apimentel1/CatchTheLight/Documentation/Phase2.md

### Front of PCB
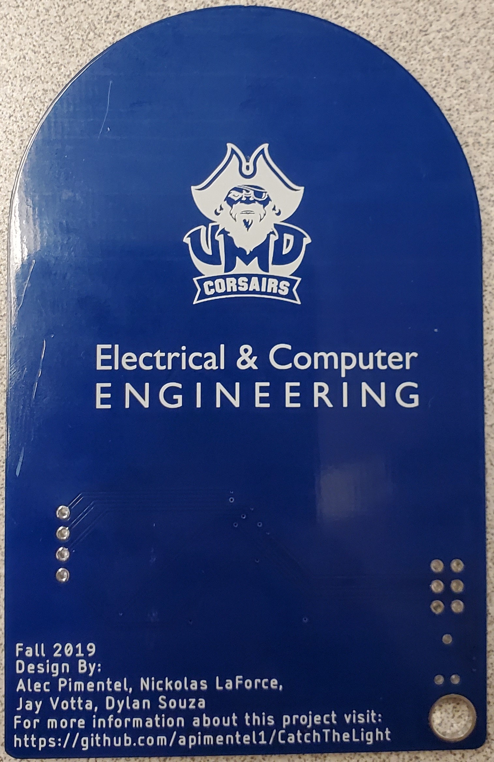
[picture p14: Documentation/Images/Phase2_PCB_Back.jpg]


### Back of PCB
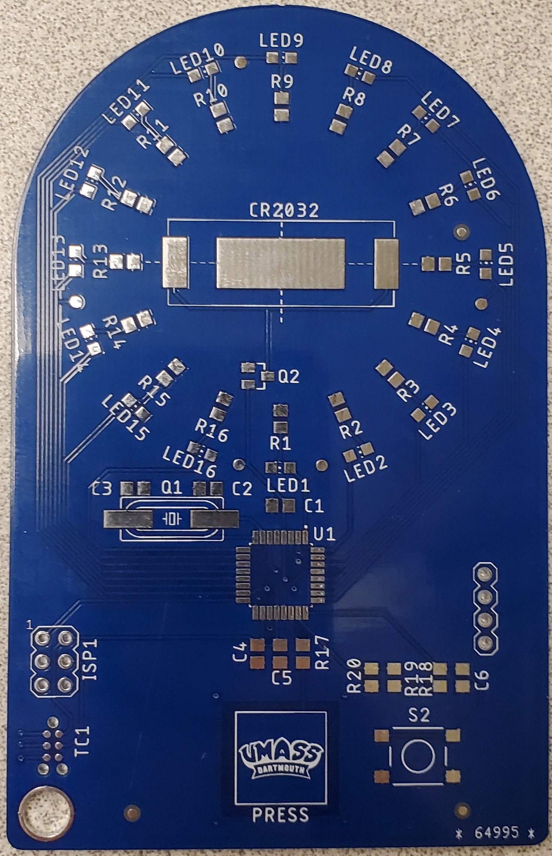
[picture p15: Documentation/Images/Phase2_PCB_Front.jpg]
