apimentel1/CatchTheLight/Initial design_reverse engineered/catch the light initial/Gerbers/CAMOutputs/Gerb screen shot Phase 1.docx

Team Life Support

Phase 1 design

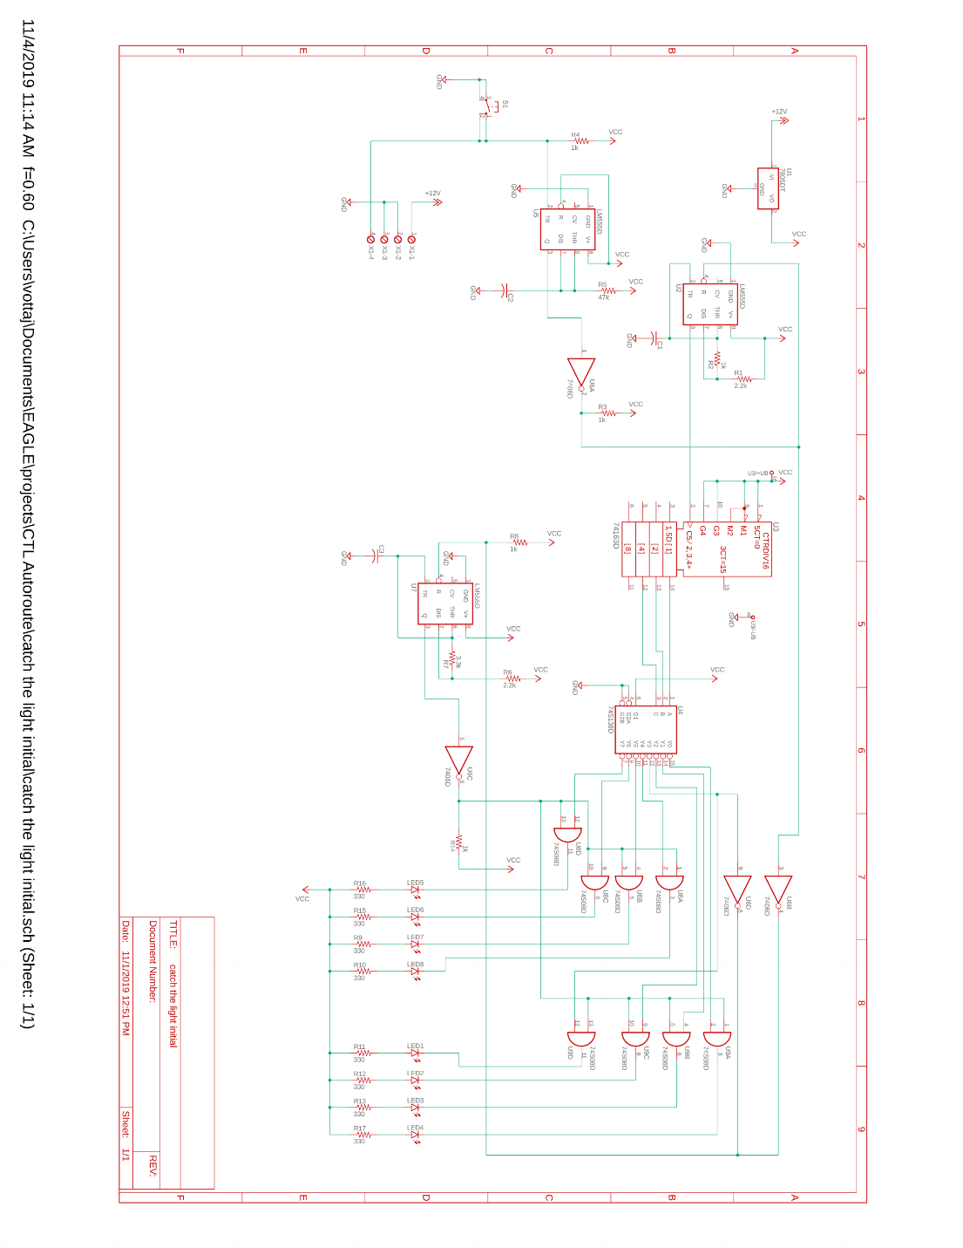
[picture p27: figure]
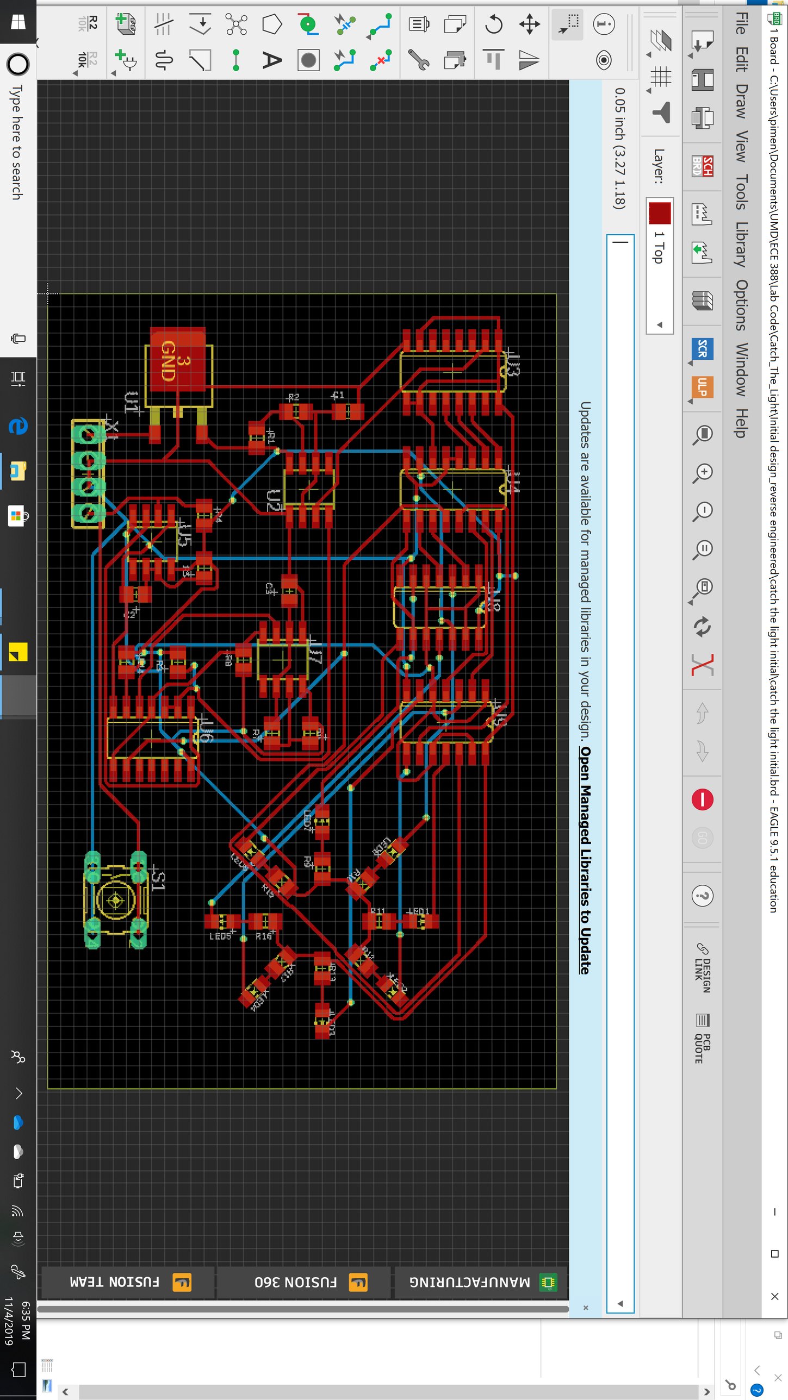
[picture p28: figure]

Top

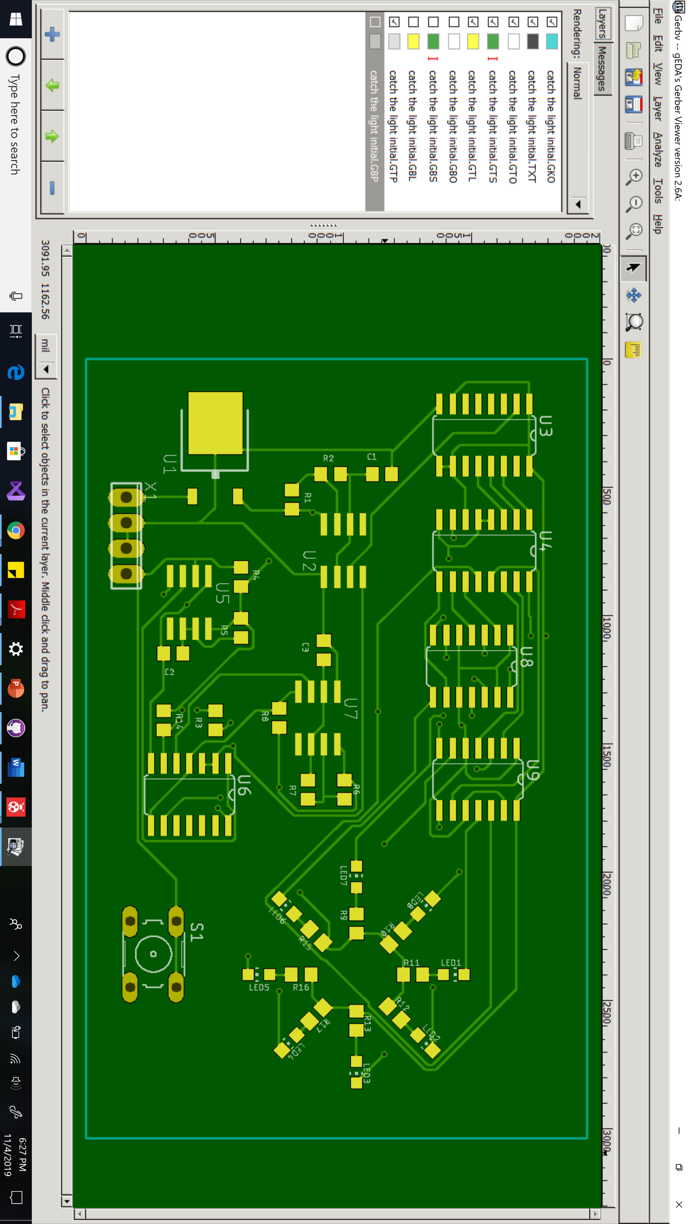
[picture p29: figure]

Bottom

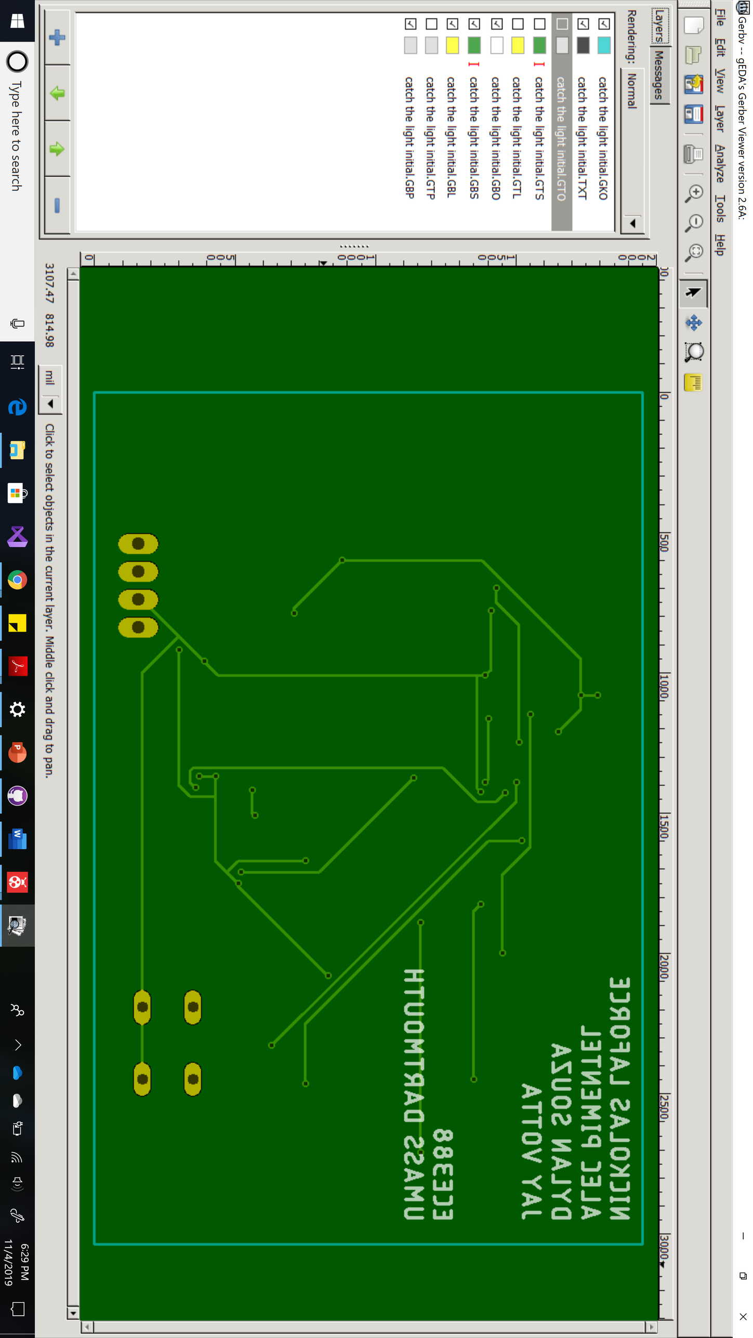
[picture p30: figure]
