apimentel1/CatchTheLight/Phase_2/Catch_the_light_Phase_2 Rev A/Gerb/Phase 2 Gerb screen shots.docx

Team Life support

Phase 2 design

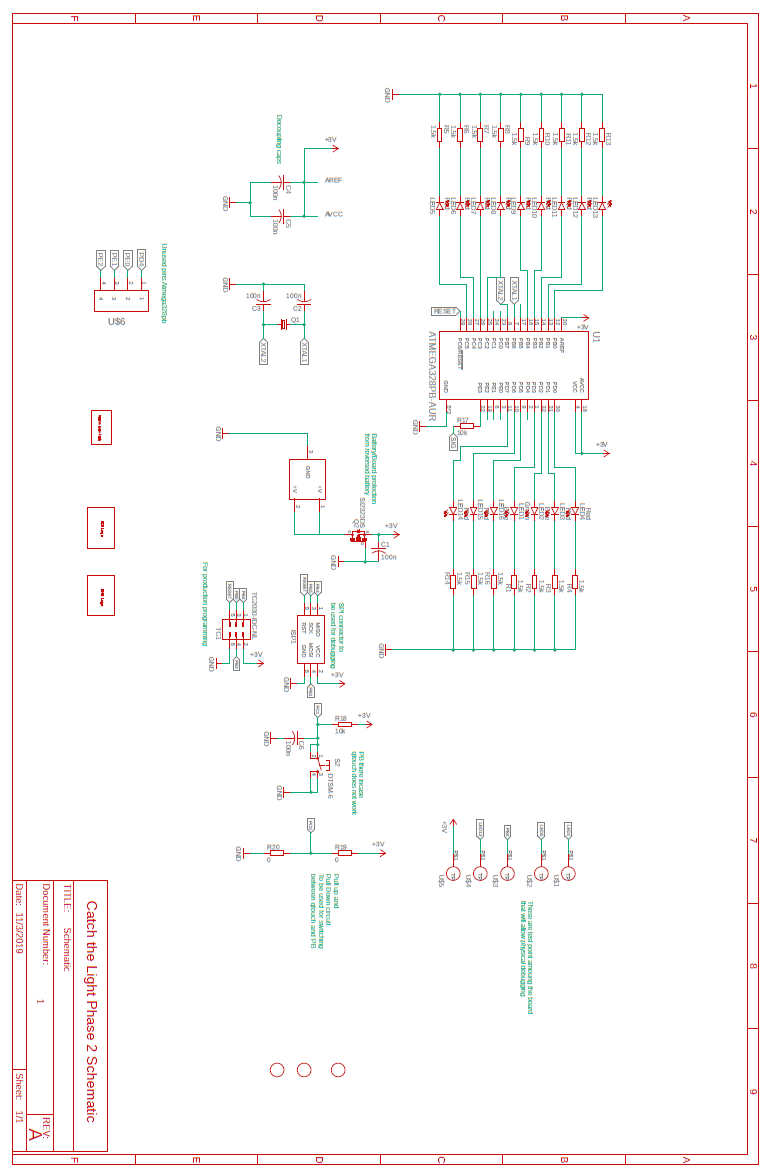
[picture p31: figure]
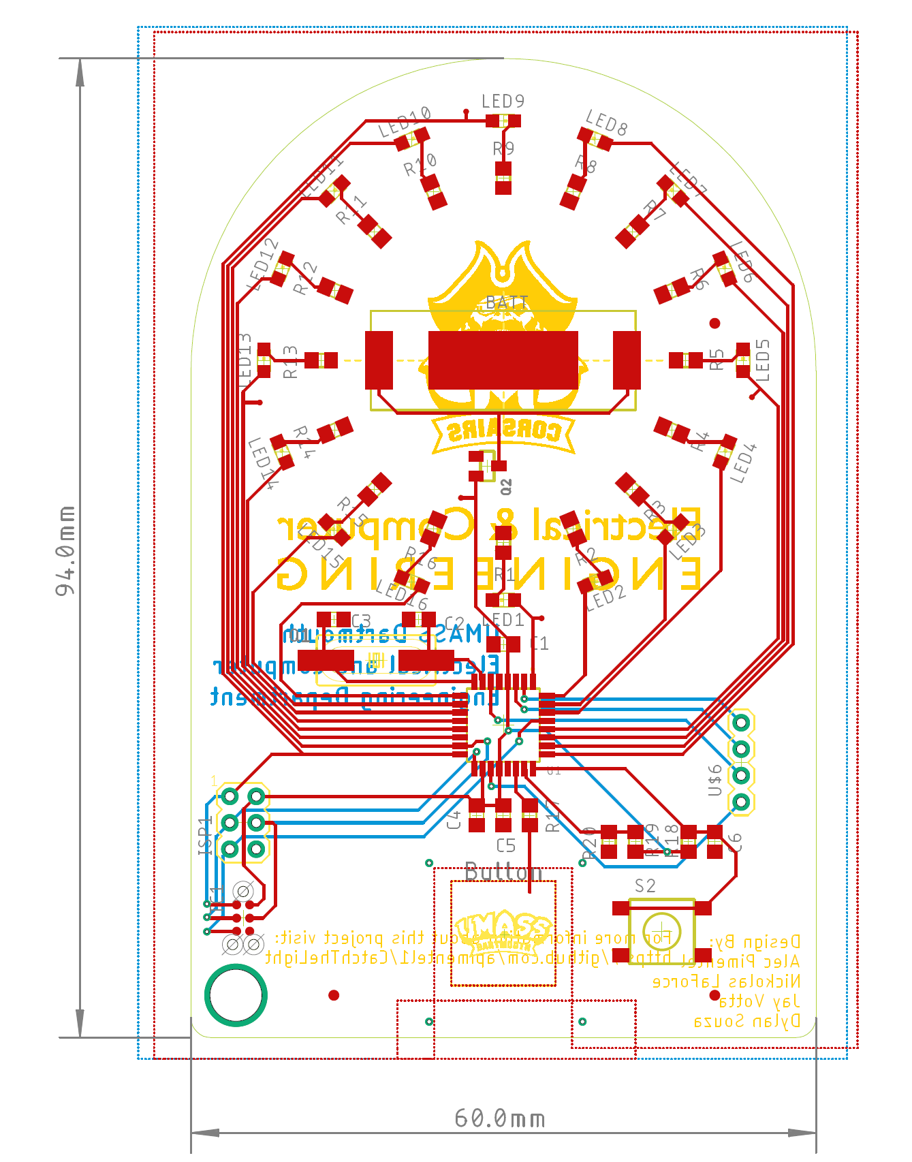
[picture p32: figure]

Top

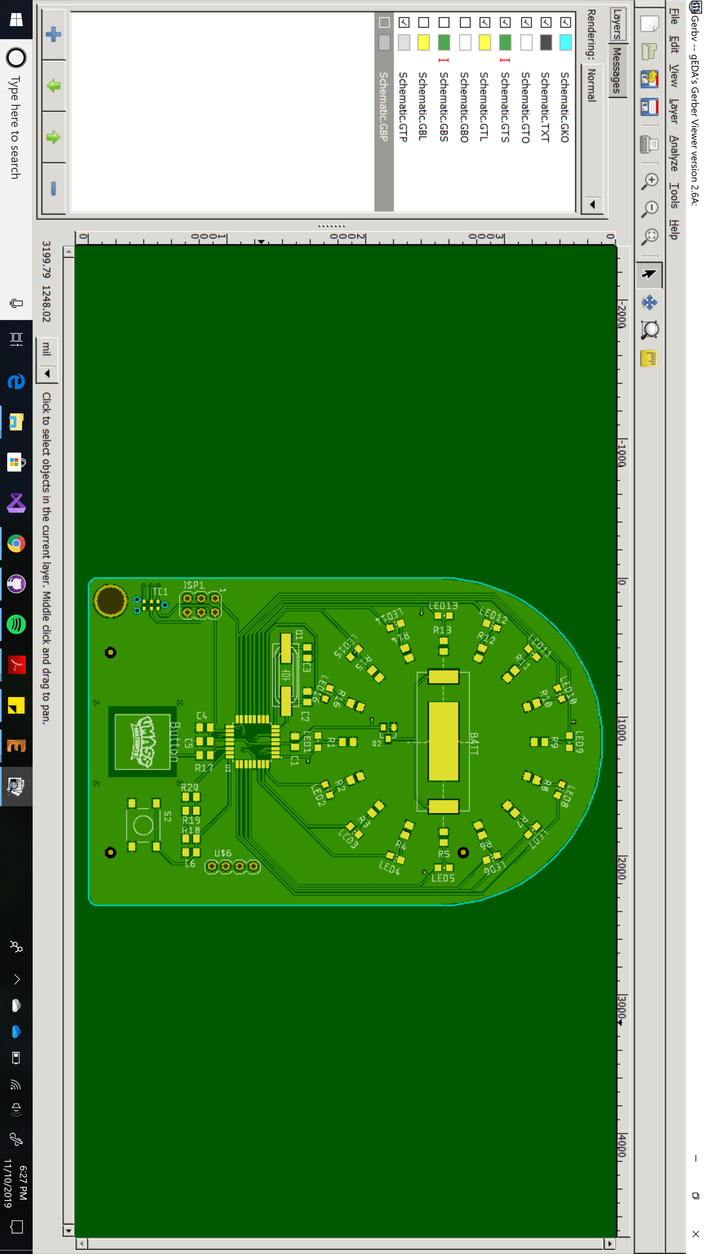
[picture p33: figure]

Bottom

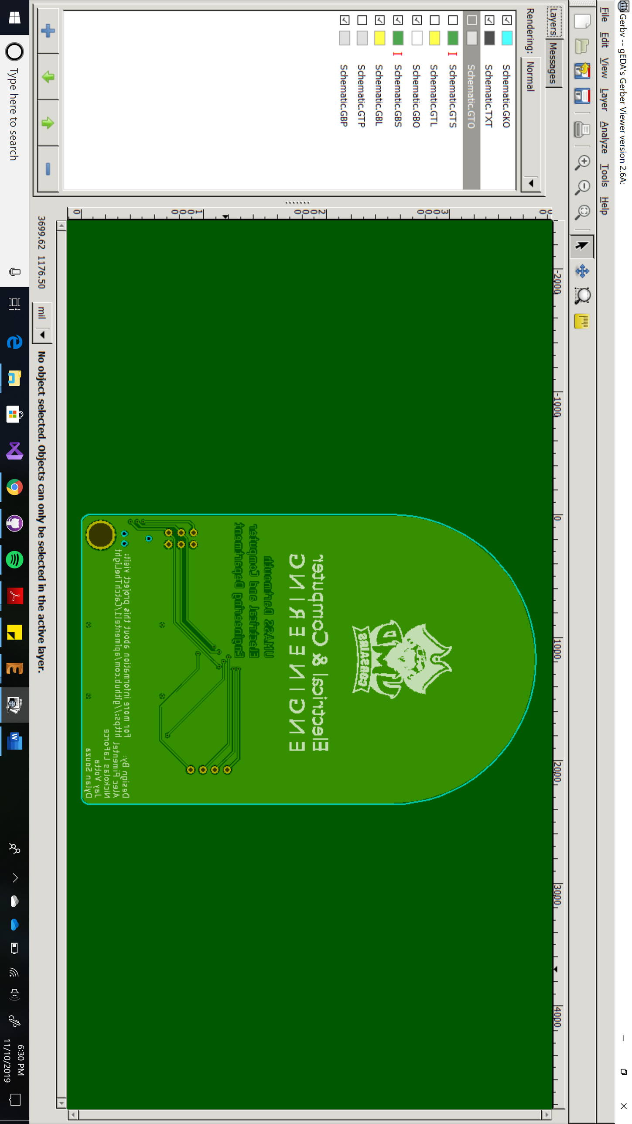
[picture p34: figure]
