apimentel1/CatchTheLight/Documentation/Images/Code_Table.JPG

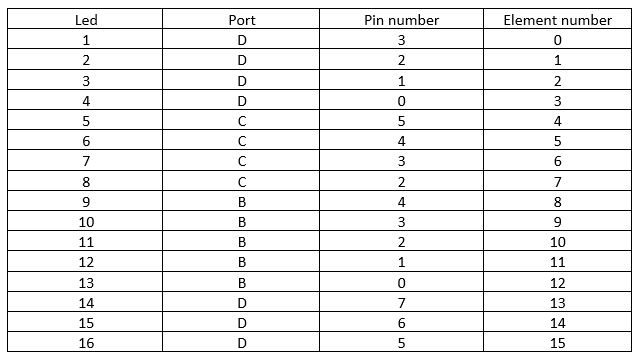
Documentation/Images/Code_Table.JPG
