apimentel1/CatchTheLight/Documentation/Images/Multisim1.PNG

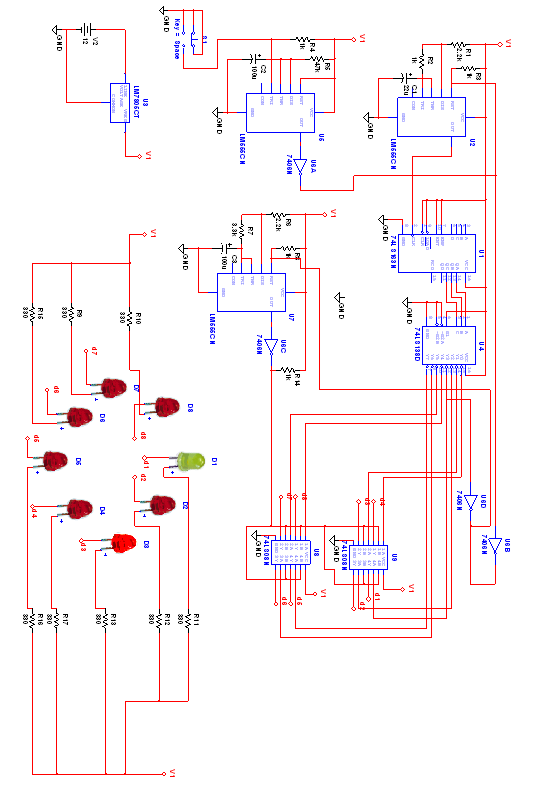
Documentation/Images/Multisim1.PNG
