apimentel1/CatchTheLight/Documentation/Images/Multisim2.PNG

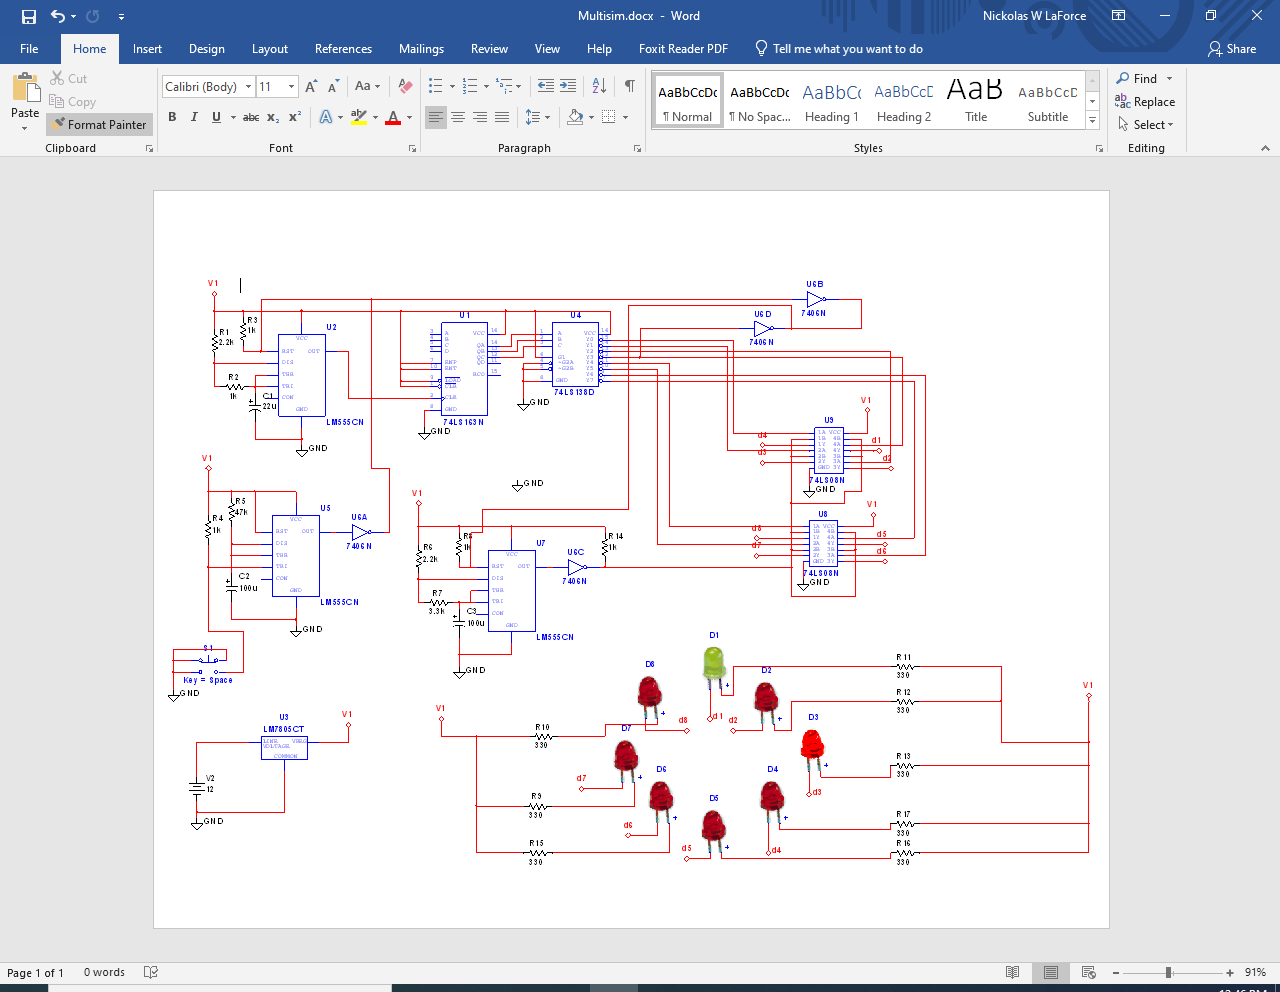
Documentation/Images/Multisim2.PNG
