apimentel1/CatchTheLight/Documentation/Images/Original_Catch_the_Light.jpg

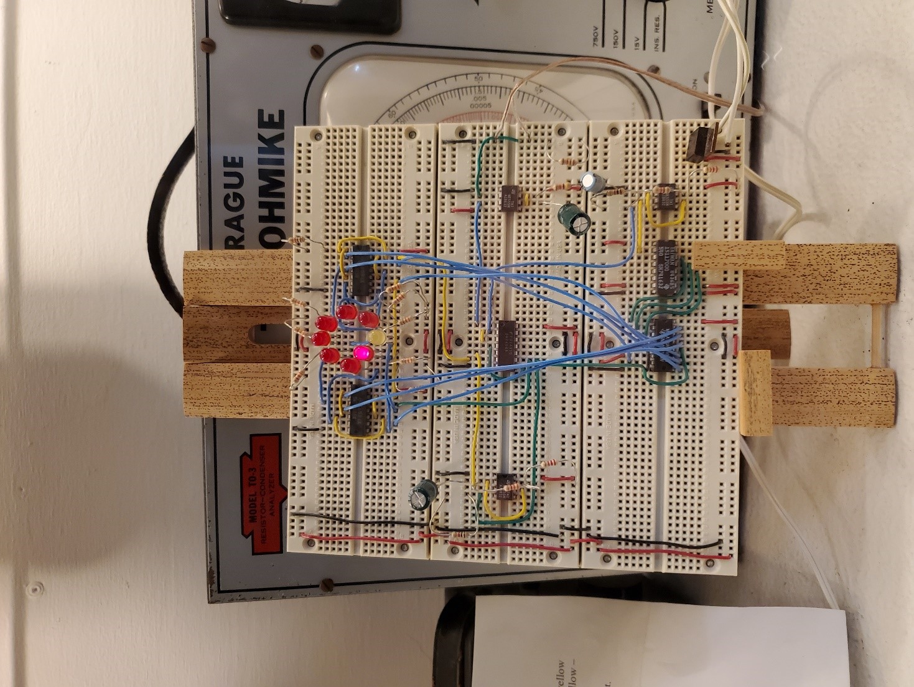
Documentation/Images/Original_Catch_the_Light.jpg
