apimentel1/CatchTheLight/Documentation/Images/Phase1_Breadboard(2).jpg

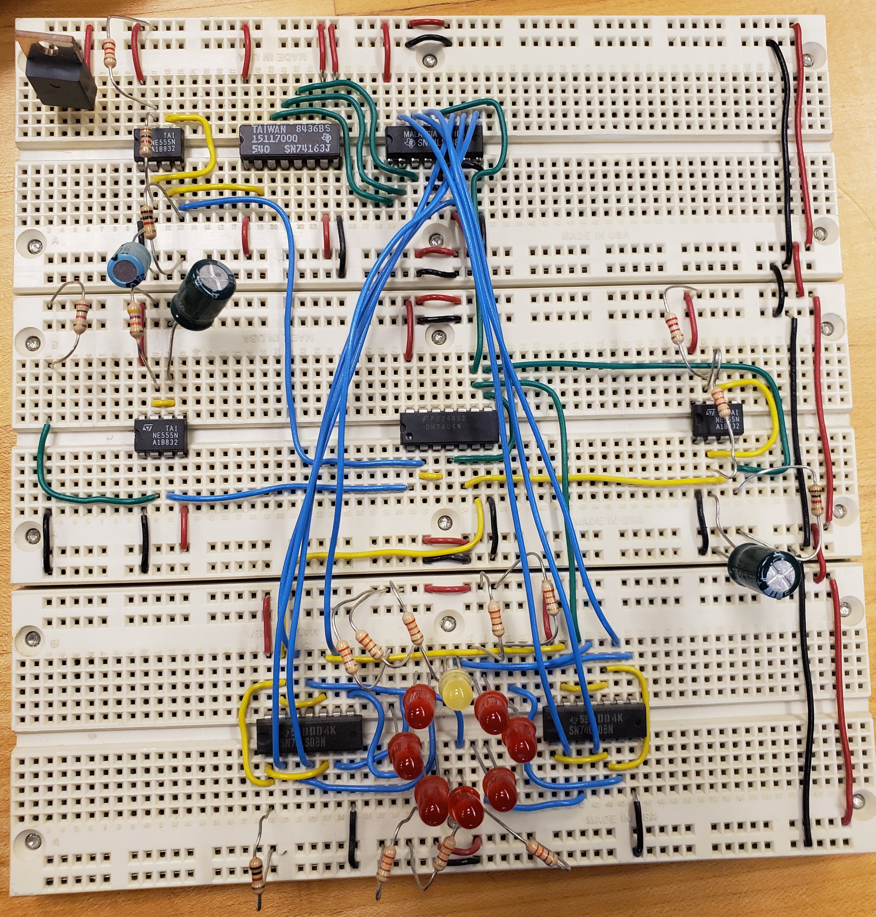
Documentation/Images/Phase1_Breadboard(2).jpg
