apimentel1/CatchTheLight/Initial design_reverse engineered/catch the light initial/1.jpg

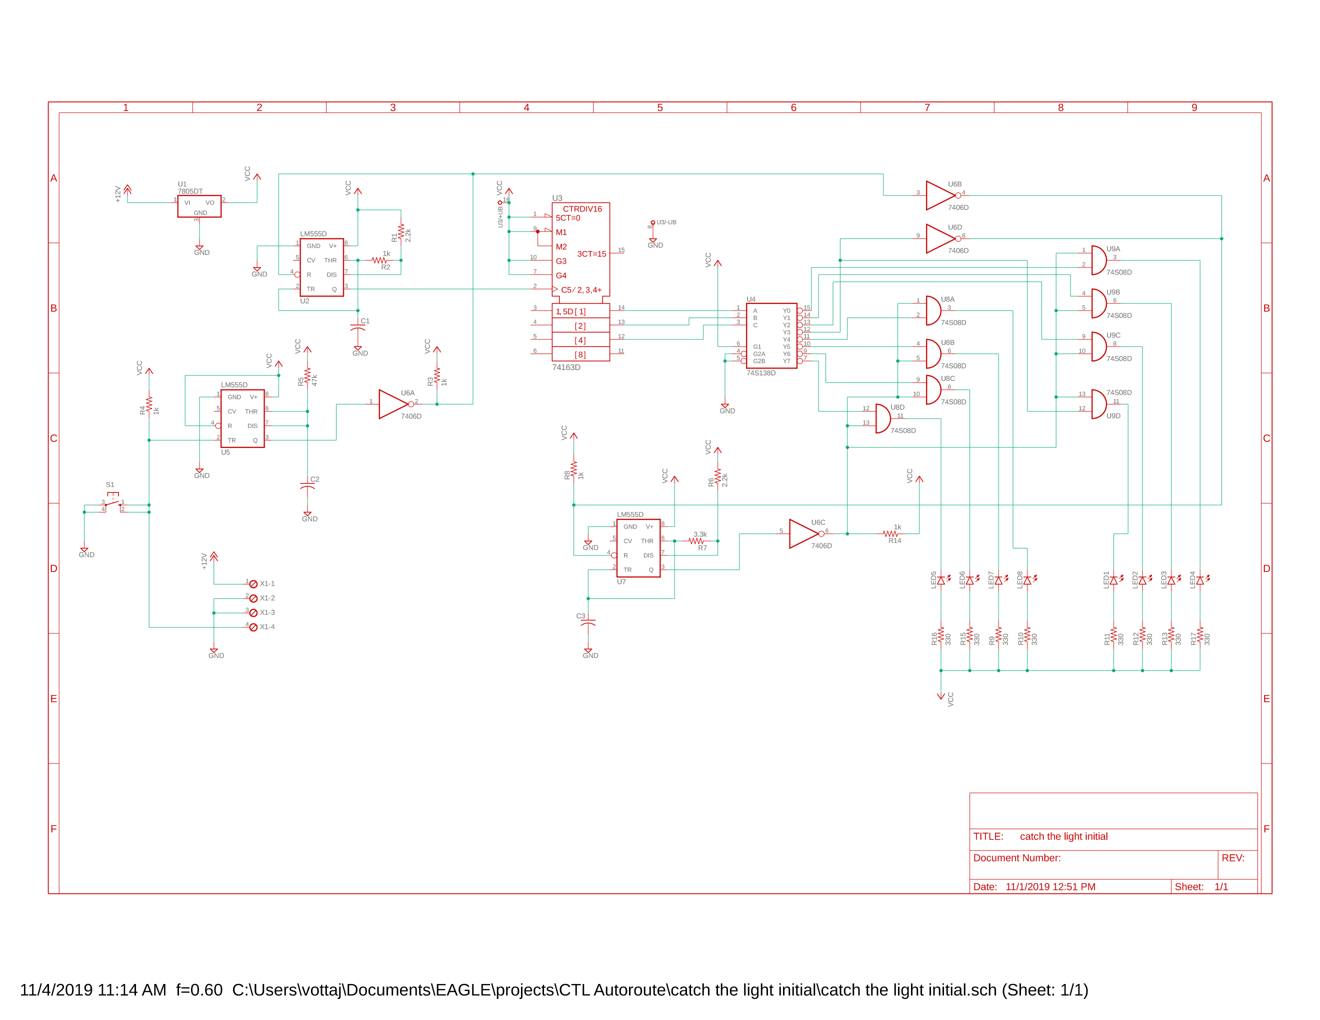
Initial design_reverse engineered/catch the light initial/1.jpg
