apimentel1/CatchTheLight/Test Requirements and Data/Catch the Light Project B.O.M (Units of 100).xlsx

 |  |  |  |  | Catch the Light Project B.O.M
 | Prototype Quantity: 100
Item | Qty | Price per unit | Total Price | UMASS Stock | Online Stock | Manufacturer P/N | Manufacturer | Packaging | Internet Link
2032 Battery | 50 | $0.30 | $14.95 | YES | 13233 | CR2032VP | Energizer | N/A | https://www.digikey.com/product-detail/en/energizer-battery-company/CR2032VP/N189-ND/704858
HC49 Crystal | 100 | $0.28 | $27.50 |  | 5728 | FC4SDCBMF3.6864-T1 | Fox Electronics | cut tape | https://www.digikey.com/product-detail/en/fox-electronics/FC4SDCBMF3.6864-T1/631-1004-1-ND/1024709
1.5k Resistor (0805) | 1600 | $0.02 | $27.20 |  | 98805 | RNCP0805FTD1K50 | Stackpole Electronics Inc | cut tape | https://www.digikey.com/product-detail/en/stackpole-electronics-inc/RNCP0805FTD1K50/RNCP0805FTD1K50CT-ND/2240572
10k Resistor (0805) | 200 | $0.05 | $10.00 |  | 37000000 | RC0805FR-0710KL | Yageo | cut tape | https://www.digikey.com/product-detail/en/yageo/RC0805FR-0710KL/311-10.0KCRCT-ND/730482
0 Ohm Resistor | 200 | $0.04 | $8.72 | YES | 62000 | RMCF0805ZT0R00 | Stackpole Electronics Inc | cut tape | https://www.digikey.com/product-detail/en/stackpole-electronics-inc/RMCF0805ZT0R00/RMCF0805ZT0R00CT-ND/1942606
Red LED (0805) | 1300 | $0.06 | $75.98 | YES | 275000 | LTST-C171KRKT | Lite-On Inc. | cut tape | https://www.digikey.com/product-detail/en/lite-on-inc/LTST-C171KRKT/160-1427-1-ND/386800
Blue LED (0805) | 200 | $0.19 | $37.58 | YES | 275000 | LTST-C171TBKT | Lite-On Inc. | cut tape | https://www.digikey.com/product-detail/en/lite-on-inc/LTST-C171TBKT/160-1645-1-ND/573585
Green LED (0805) | 100 | $0.36 | $36.27 | YES | 127000 | LTST-C170TGKT | Lite-On Inc. | cut tape | https://www.digikey.com/product-detail/en/lite-on-inc/LTST-C170TGKT/160-1887-1-ND/3306140
Atmega328PB | 100 | $1.25 | $125.00 |  | 16189 | ATMEGA328PB-AUR | Microchip Technology | cut tape | https://www.digikey.com/product-detail/en/microchip-technology/ATMEGA328PB-AUR/ATMEGA328PB-AURCT-ND/5722706
Fiducial | 300 | $0 | $0 |  | N/A | N/A | N/A | N/A | N/A
100nF Cap (0805) | 600 | $0.03 | $20.40 |  | 1700000 | CC0805ZRY5V9BB104 | Yageo | cut tape | https://www.digikey.com/product-detail/en/yageo/CC0805ZRY5V9BB104/311-1361-1-ND/2103145
MOSFET | 100 | $0.45 | $45.00 |  | 151582 | SI2323DS-T1-E3 | Vishay Siliconix | cut tape | https://www.digikey.com/product-detail/en/vishay-siliconix/SI2323DS-T1-E3/SI2323DS-T1-E3CT-ND/1656850
Push Button | 100 | $0.58 | $58.00 |  | 214640 | B3FS-1012P | Omron Electronics Inc-EMC Div | cut tape | https://www.digikey.com/product-detail/en/omron-electronics-inc-emc-div/B3FS-1012P/SW1237CT-ND/2747253
Pinheader | 10 | $0.37 | $3.70 |  | 2600 | M20-9991046 | Harwin | single | https://www.digikey.com/product-detail/en/harwin-inc/M20-9991046/952-1843-ND/3727810
Total |  |  | $490.31 |  | NOTE: All cut tape componenets have a $7.00 reel fee
Per-unit total |  |  | $4.90
