apimentel1/CatchTheLight/Phase_2/Catch the Light Project B.O.M (Final).xlsx

 |  |  |  |  |  |  | Catch the Light Project B.O.M
 |  | Board Quantity: 100
Item | Qty Per Board | Package Qty | Price per unit | Total Price Per Board | Total Price per 100 | Online Stock | Manufacturer P/N | Manufacturer | Packaging | Internet Link
2032 Battery | 1 | 50 | $0.30 | $0.30 | $14.95 | 13233 | CR2032VP | Energizer | N/A | https://www.digikey.com/product-detail/en/energizer-battery-company/CR2032VP/N189-ND/704858
HC49 Crystal | 0 | 100 | $0.00 | $0.00 | $0.00 | 5728 | FC4SDCBMF3.6864-T1 | Fox Electronics | cut tape | https://www.digikey.com/product-detail/en/fox-electronics/FC4SDCBMF3.6864-T1/631-1004-1-ND/1024709
1.5k Resistor (0805) | 16 | 1600 | $0.02 | $0.27 | $27.20 | 98805 | RNCP0805FTD1K50 | Stackpole Electronics Inc | cut tape | https://www.digikey.com/product-detail/en/stackpole-electronics-inc/RNCP0805FTD1K50/RNCP0805FTD1K50CT-ND/2240572
10k Resistor (0805) | 2 | 200 | $0.05 | $0.10 | $10.00 | 37000000 | RC0805FR-0710KL | Yageo | cut tape | https://www.digikey.com/product-detail/en/yageo/RC0805FR-0710KL/311-10.0KCRCT-ND/730482
0 Ohm Resistor | 2 | 200 | $0.00 | $0.00 | $0.00 | 62000 | RMCF0805ZT0R00 | Stackpole Electronics Inc | cut tape | https://www.digikey.com/product-detail/en/stackpole-electronics-inc/RMCF0805ZT0R00/RMCF0805ZT0R00CT-ND/1942606
Red LED (0805) | 13 | 1300 | $0.0032 | $0.04 | $4.16 | 275000 | LTST-C171KRKT | Lite-On Inc. | cut tape | https://www.digikey.com/product-detail/en/lite-on-inc/LTST-C171KRKT/160-1427-1-ND/386800
Blue LED (0805) | 2 | 200 | $0.0032 | $0.01 | $0.64 | 275000 | LTST-C171TBKT | Lite-On Inc. | cut tape | https://www.digikey.com/product-detail/en/lite-on-inc/LTST-C171TBKT/160-1645-1-ND/573585
Green LED (0805) | 1 | 100 | $0.0032 | $0.0032 | $0.32 | 127000 | LTST-C170TGKT | Lite-On Inc. | cut tape | https://www.digikey.com/product-detail/en/lite-on-inc/LTST-C170TGKT/160-1887-1-ND/3306140
Atmega328PB | 1 | 100 | $1.25 | $1.25 | $125.00 | 16189 | ATMEGA328PB-AUR | Microchip Technology | cut tape | https://www.digikey.com/product-detail/en/microchip-technology/ATMEGA328PB-AUR/ATMEGA328PB-AURCT-ND/5722706
Fiducial | 3 | 300 | $0 | $0.00 | $0 | N/A | N/A | N/A | N/A | N/A
100nF Cap (0805) | 4 | 400 | $0.03 | $0.14 | $13.60 | 1700000 | CC0805ZRY5V9BB104 | Yageo | cut tape | https://www.digikey.com/product-detail/en/yageo/CC0805ZRY5V9BB104/311-1361-1-ND/2103145
MOSFET | 1 | 100 | $0.45 | $0.45 | $45.00 | 151582 | SI2323DS-T1-E3 | Vishay Siliconix | cut tape | https://www.digikey.com/product-detail/en/vishay-siliconix/SI2323DS-T1-E3/SI2323DS-T1-E3CT-ND/1656850
Push Button | 0 | 100 | $0.58 | $0.00 | $58.00 | 214640 | B3FS-1012P | Omron Electronics Inc-EMC Div | cut tape | https://www.digikey.com/product-detail/en/omron-electronics-inc-emc-div/B3FS-1012P/SW1237CT-ND/2747253
Pinheader | 0 | 10 | $0.37 | $0.00 | $3.70 | 2600 | M20-9991046 | Harwin | single | https://www.digikey.com/product-detail/en/harwin-inc/M20-9991046/952-1843-ND/3727810
Battery Holder | 1 | 100 | $0.56 | $0.56 | $55.68 | 14732 | BC-2003-2-TR | MPD | cut tape | https://www.digikey.com/product-detail/en/mpd-memory-protection-devices/BC-2003-2-TR/BC-2003-2-DKR-ND/8119249
18pF Cap (0805) | 2 | 200 | $0.00 | $0.00 | $0.00 |  | CC0805JRNPO9BN220 | Yageo | cut tape | https://www.digikey.com/product-detail/en/yageo/CC0805JRNPO9BN220/311-1103-6-ND/579028
 | Total |  |  | $358.25 |  |  | NOTE: All cut tape componenets have a $7.00 reel fee
 | Per-unit total |  |  | $3.12
