apimentel1/CatchTheLight/Phase_2/Lazer Cutters/Battery tray bottom.dxf

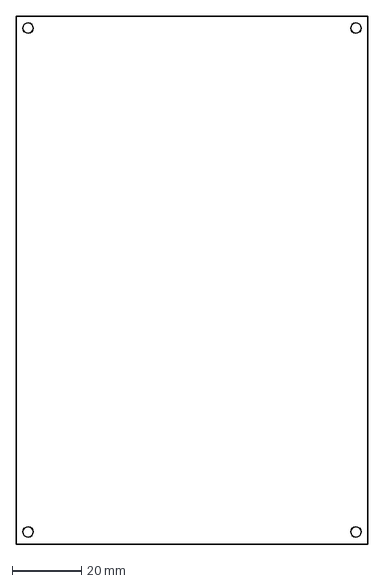
[picture p42: CAD file, 2019-11-30]
Phase_2/Lazer Cutters/Battery tray bottom.dxf
101.6 x 152.4 mm
