apimentel1/CatchTheLight/Phase_2/Lazer Cutters/Battery tray top.dxf

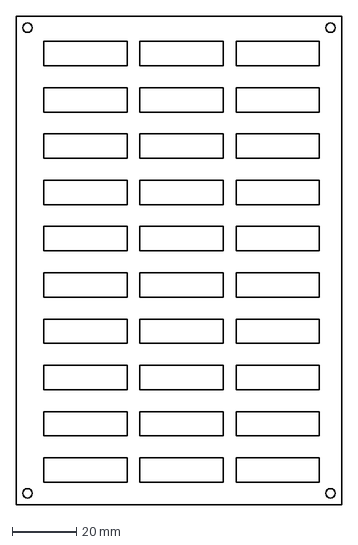
[picture p43: CAD file, 2019-11-30]
Phase_2/Lazer Cutters/Battery tray top.dxf
101.6 x 152.4 mm
