apimentel1/CatchTheLight/Test Requirements and Data/Engineering Test Requirements .xlsx

Requirement # | Function | Engineering Requirement | Unit of Measure | Actual Value | Limit Value
#3.1.1 | Hardware | The board operates using the Atmega328pb microcontroller | - |  | Yes
#3.1.2 | Hardware | Capacitive touch button present on board | - |  | Yes
#3.1.2 | Mechanical | Capacitive touch button responds to user's press in 0.1 seconds | sec |  | <1 sec ± 10% error
#3.1.3 | Hardware | 16 LEDs are present in the design (13 Red, 2 Blue, 1 Green) | - |  | 16 LEDs
#3.1.3 | Aesthetic | 16 LEDs are in a circle on PCB | Diameter (mm) |  | 46mm
#3.1.4 | Aesthethic | PCB silkscreen has UMASS Dartmouth mascot | - |  | Yes
#3.1.4 | Aesthethic | PCB silkscreen has the name of university (UMASS Dartmouth) | - |  | Yes
#3.1.4 | Aesthethic | PCB silkscreen has the name of engineering department (ECE) | - |  | Yes
#3.1.5 | Cost | Low cost per unit | Dollars |  | < $3.00 per unit
#3.1.6 | Software | Uses atmega328pb's sleep mode as self-latching power supply | - |  | No lights on/shining
#3.1.6 | Software | Atmega puts board into sleep mode from no user activity | sec |  | 30 sec ± 10% error
#3.1.7 | Hardware | PCB powered by coin cell | - |  | Yes
#3.1.7 | Hardware | Coin cell battery voltage | V |  | 3V ± 10% error
Additional Tests (Not specified in the Requirements Document)
Requirement # | Function | Engineering Requirement | Unit of Measure | Actual Value | Limit Value
#A1 | Software | Lights reverse direction every time the user wins | - |  | Yes
#A2 | Software | The game has 7 different levels | - |  | Yes
#A3 | Software | All LEDs blink 5 times when the user catches the light | - |  | Yes
#A4 | Software | When the user doesn’t successfully catch light, the missed light stays on for 100ms | ms |  | Yes
#A5 | Software | All game levels work correctly / without delay | - |  | Yes
