apimentel1/CatchTheLight/Documentation/Images/Current_Test_Table.JPG

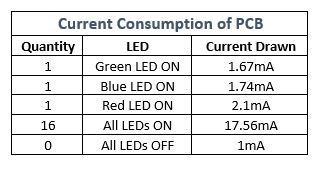
Documentation/Images/Current_Test_Table.JPG
