apimentel1/CatchTheLight/Phase_2/Schematic.pdf

A

A

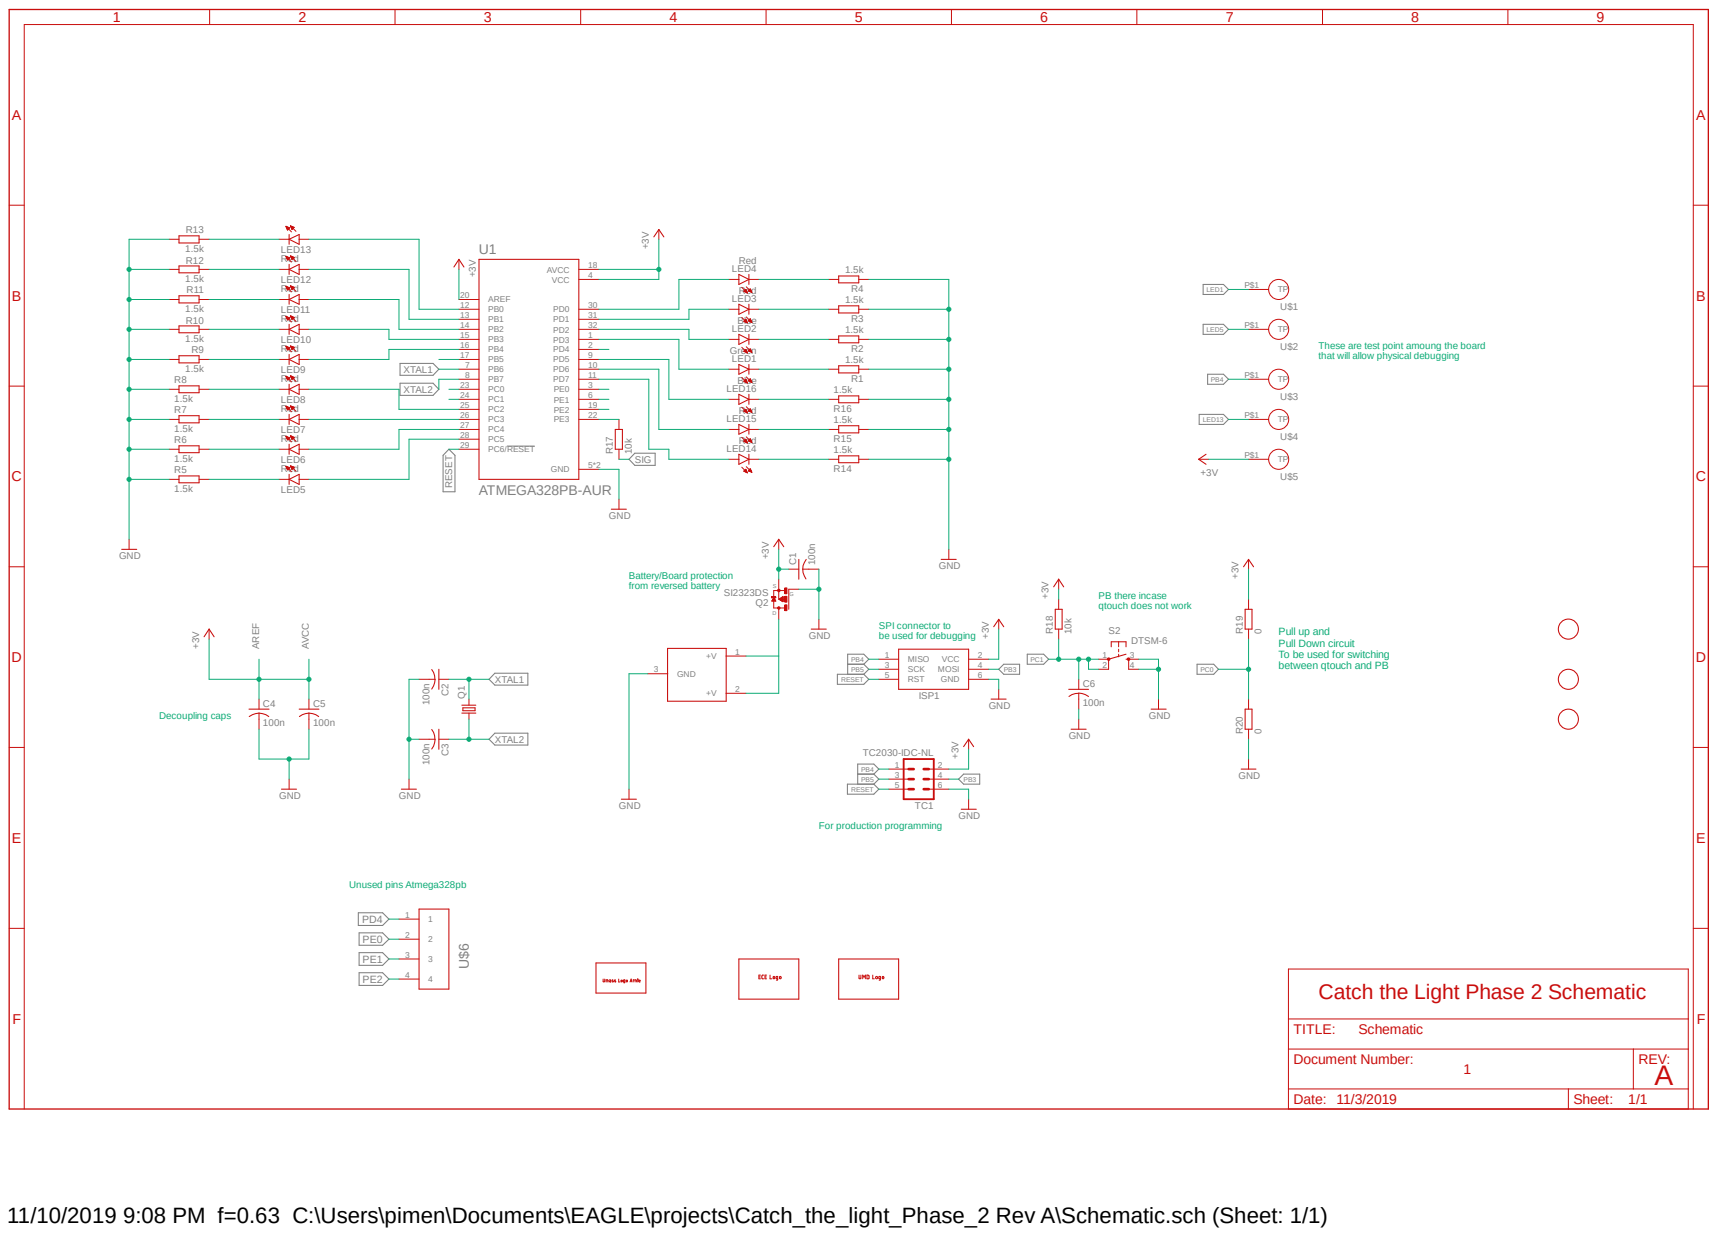
[picture p46: page 1]

These are test point amoung the board
that will allow physical debugging

PB there incase qtouch does not work SPI connector to be used for debugging

Pull up and Pull Down circuit To be used for switching

between qtouch and PB

Catch the Light Phase 2 Schematic 1

Date: Sheet: | REV: TITLE: Document Number:

11/10/2019 9:08 PM f=0.63 C:\Users\pimen\Documents\EAGLE\projects\Catch_the_light_Phase_2 Rev A\Schematic.sch (Sheet: 1/1)
