apimentel1/CatchTheLight/Initial design_reverse engineered/catch the light initial/catch the light.pdf

A

A

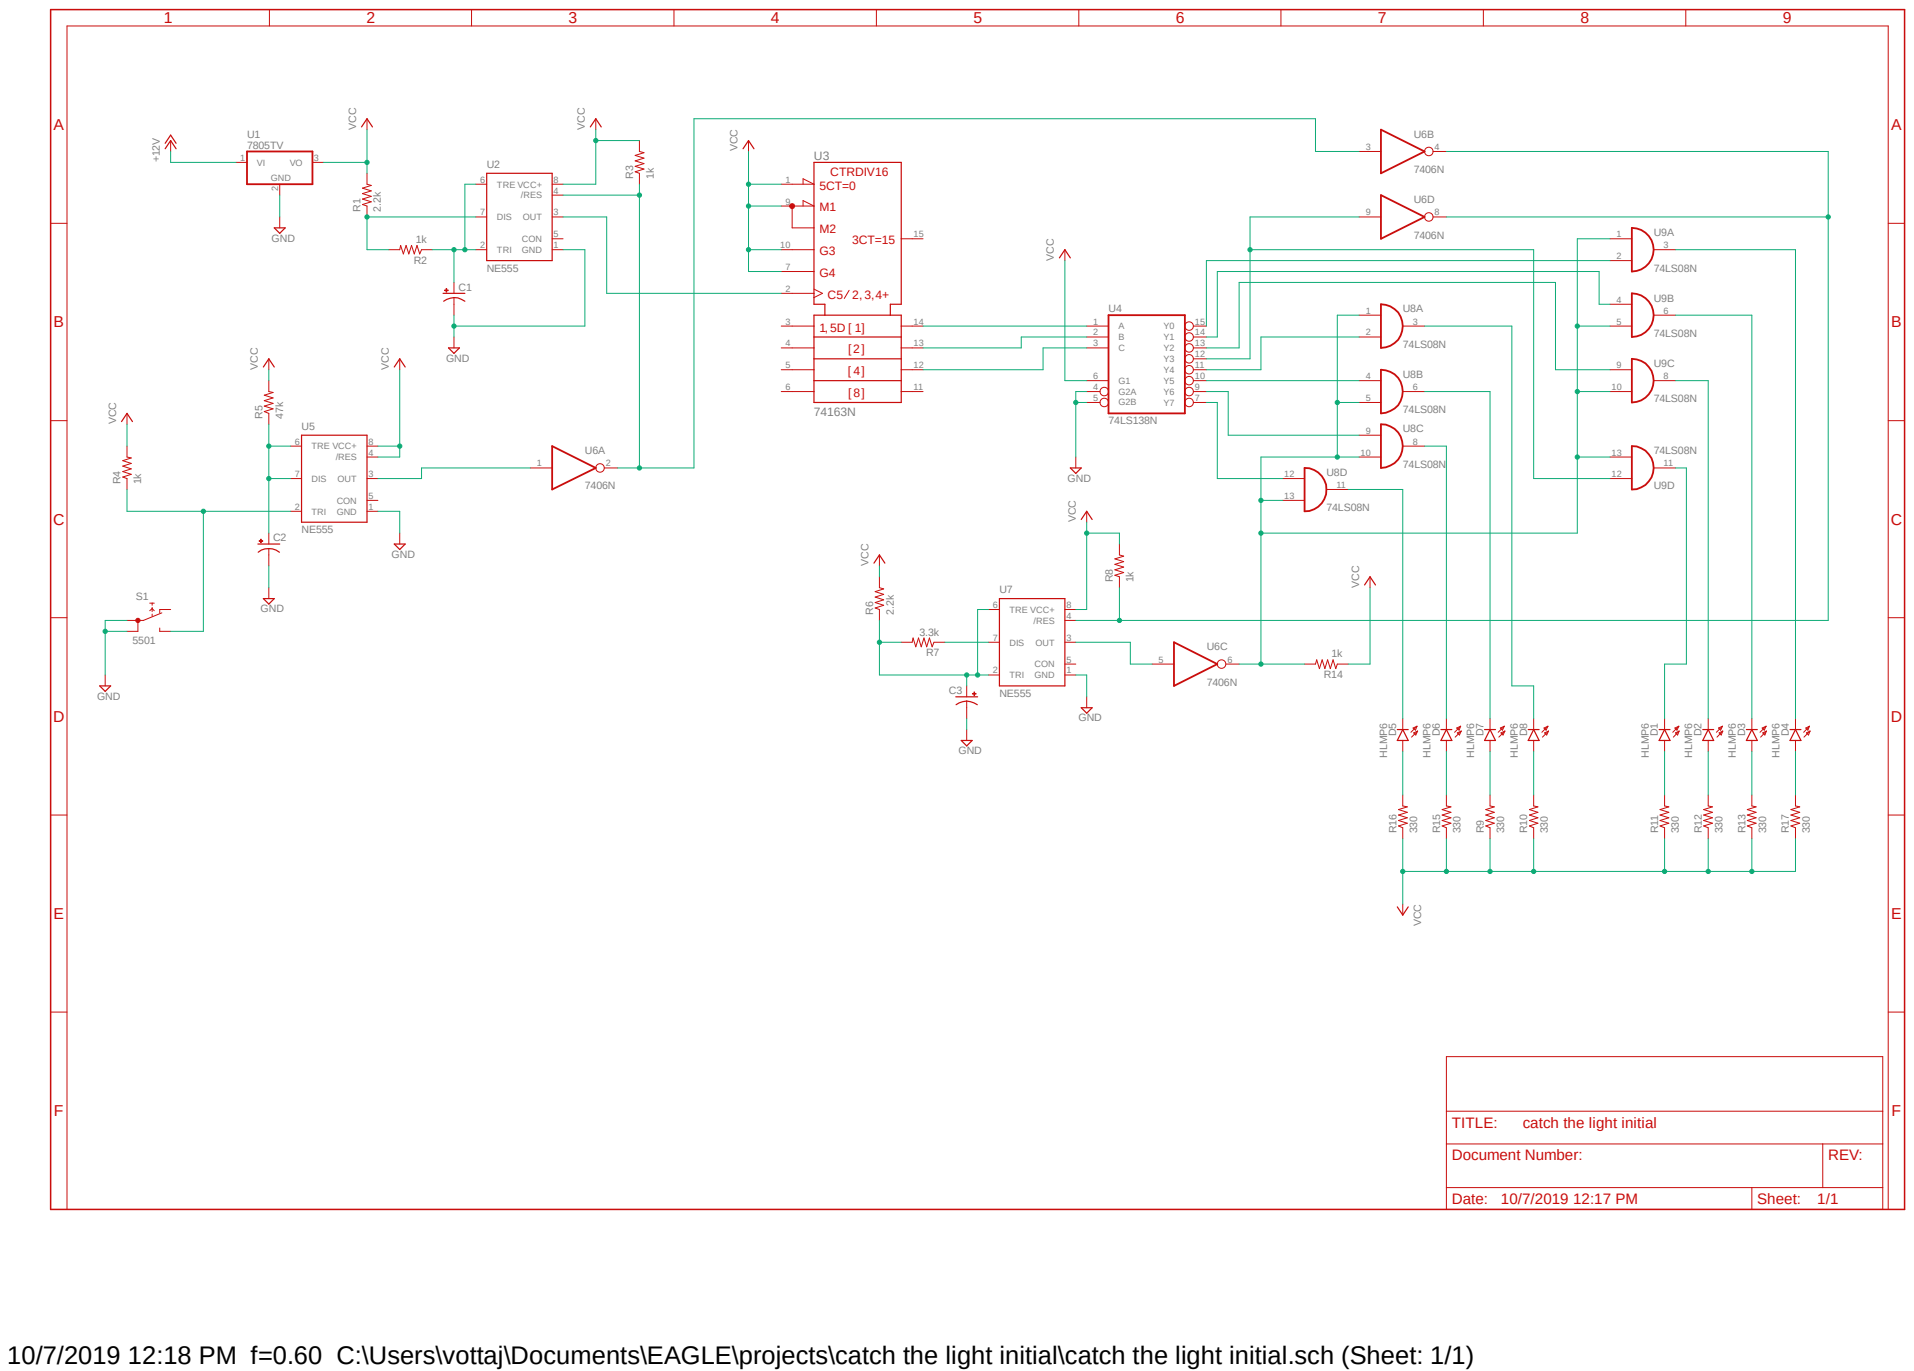
[picture p47: page 1]

2 VO 3 U1 TRE 6 OUT 3 DIS 7 TRI 2 VCC+ 8 GND 1 CON 5

catch the light initial

10/7/2019 12:18 PM f=0.60 C:\Users\vottaj\Documents\EAGLE\projects\catch the light initial\catch the light initial.sch (Sheet: 1/1)
