apimentel1/CatchTheLight/Initial design_reverse engineered/Fritzing_Breadboard_Layout.pdf

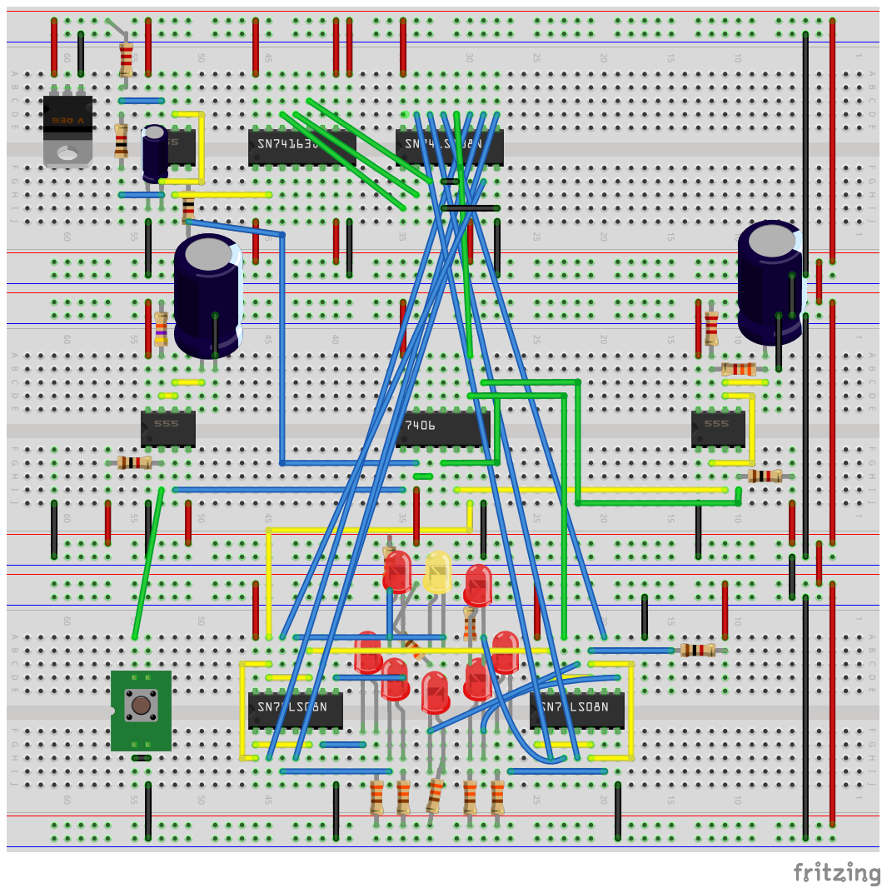
[picture p48: page 1]
