apimentel1/CatchTheLight/Initial design_reverse engineered/catch the light initial/catch the light_b.pdf

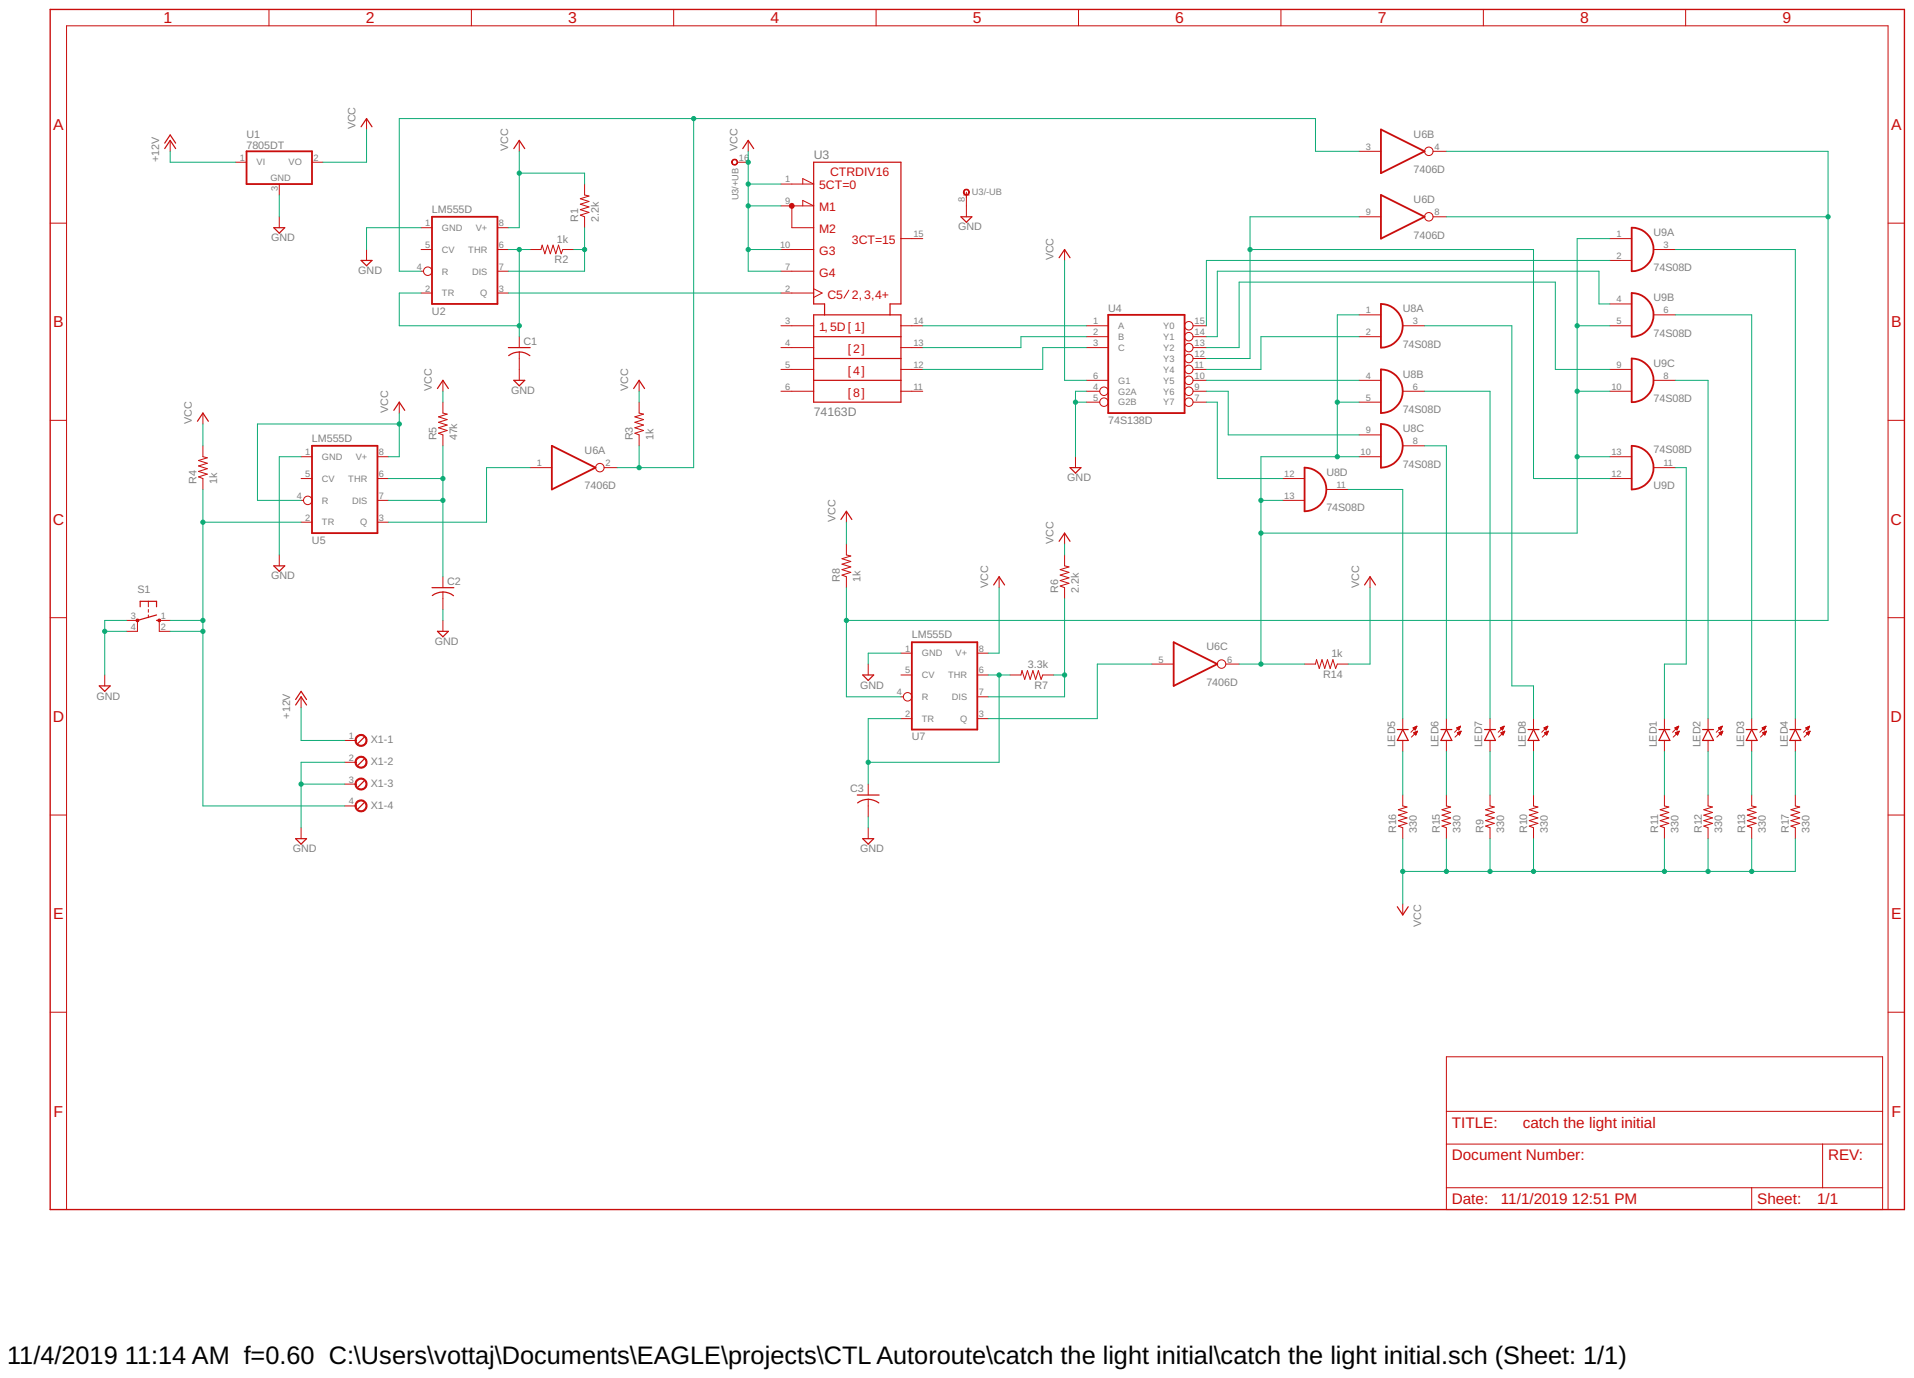
[picture p49: page 1]

catch the light initial

11/4/2019 11:14 AM f=0.60 C:\Users\vottaj\Documents\EAGLE\projects\CTL Autoroute\catch the light initial\catch the light initial.sch (Sheet: 1/1)
