apimentel1/CatchTheLight/Initial design_reverse engineered/catch the light initial/catch the light_a.pdf

A

A

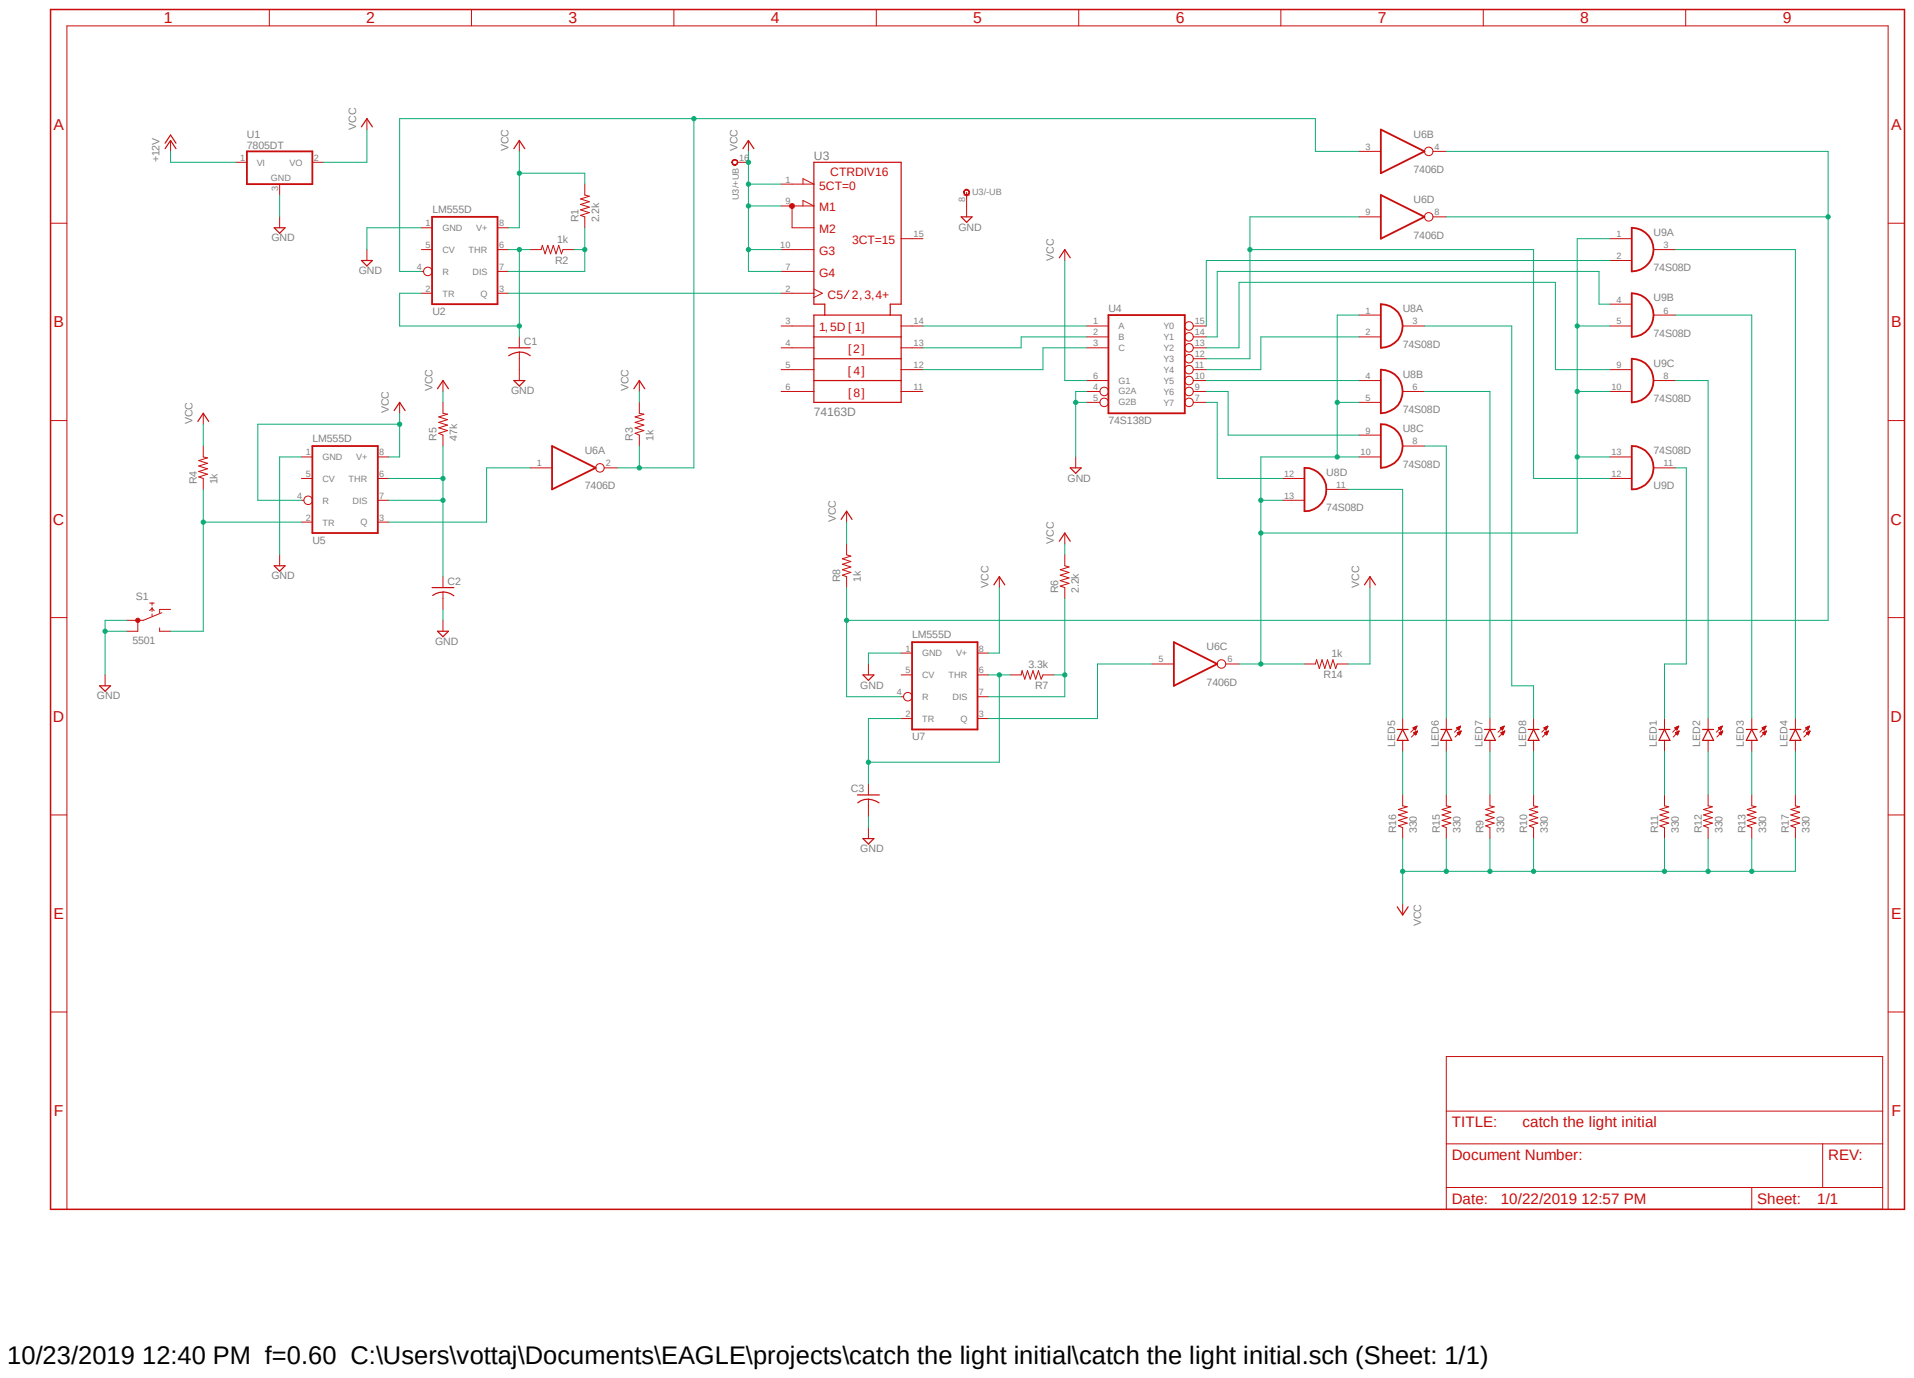
[picture p50: page 1]

catch the light initial

10/23/2019 12:40 PM f=0.60 C:\Users\vottaj\Documents\EAGLE\projects\catch the light initial\catch the light initial.sch (Sheet: 1/1)
