apimentel1/CatchTheLight/Phase_2/Board Layout.pdf

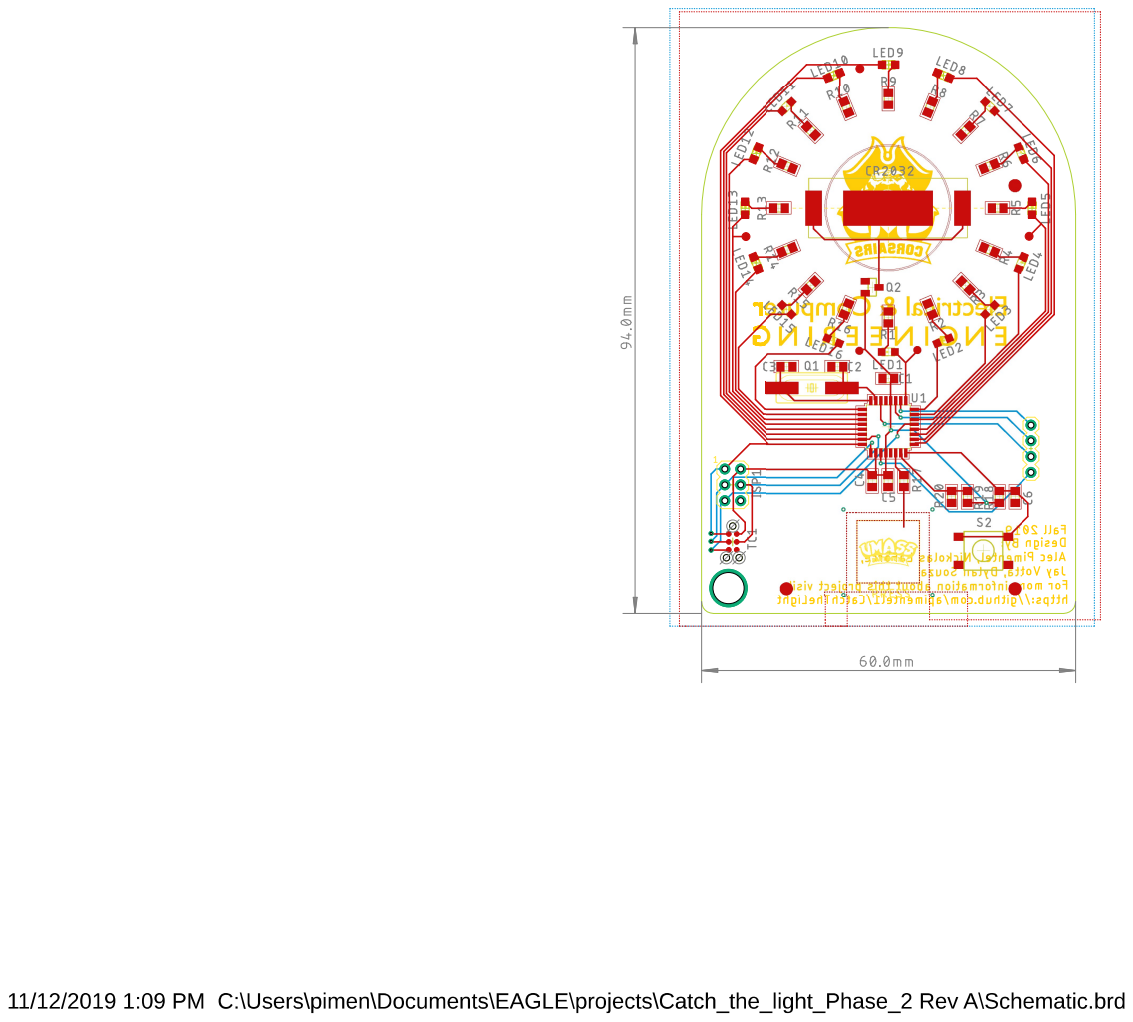
[picture p51: page 1]
