apimentel1/CatchTheLight/(list of files, drawings)

Other design files:
Initial design_reverse engineered/catch the light.ms14
