apimentel1/CatchTheLight/Phase_2/Catch_the_light_Phase_2 Rev A/Schematic.brd

## EAGLE design Phase_2/Catch_the_light_Phase_2 Rev A/Schematic.brd (2019-12-04)

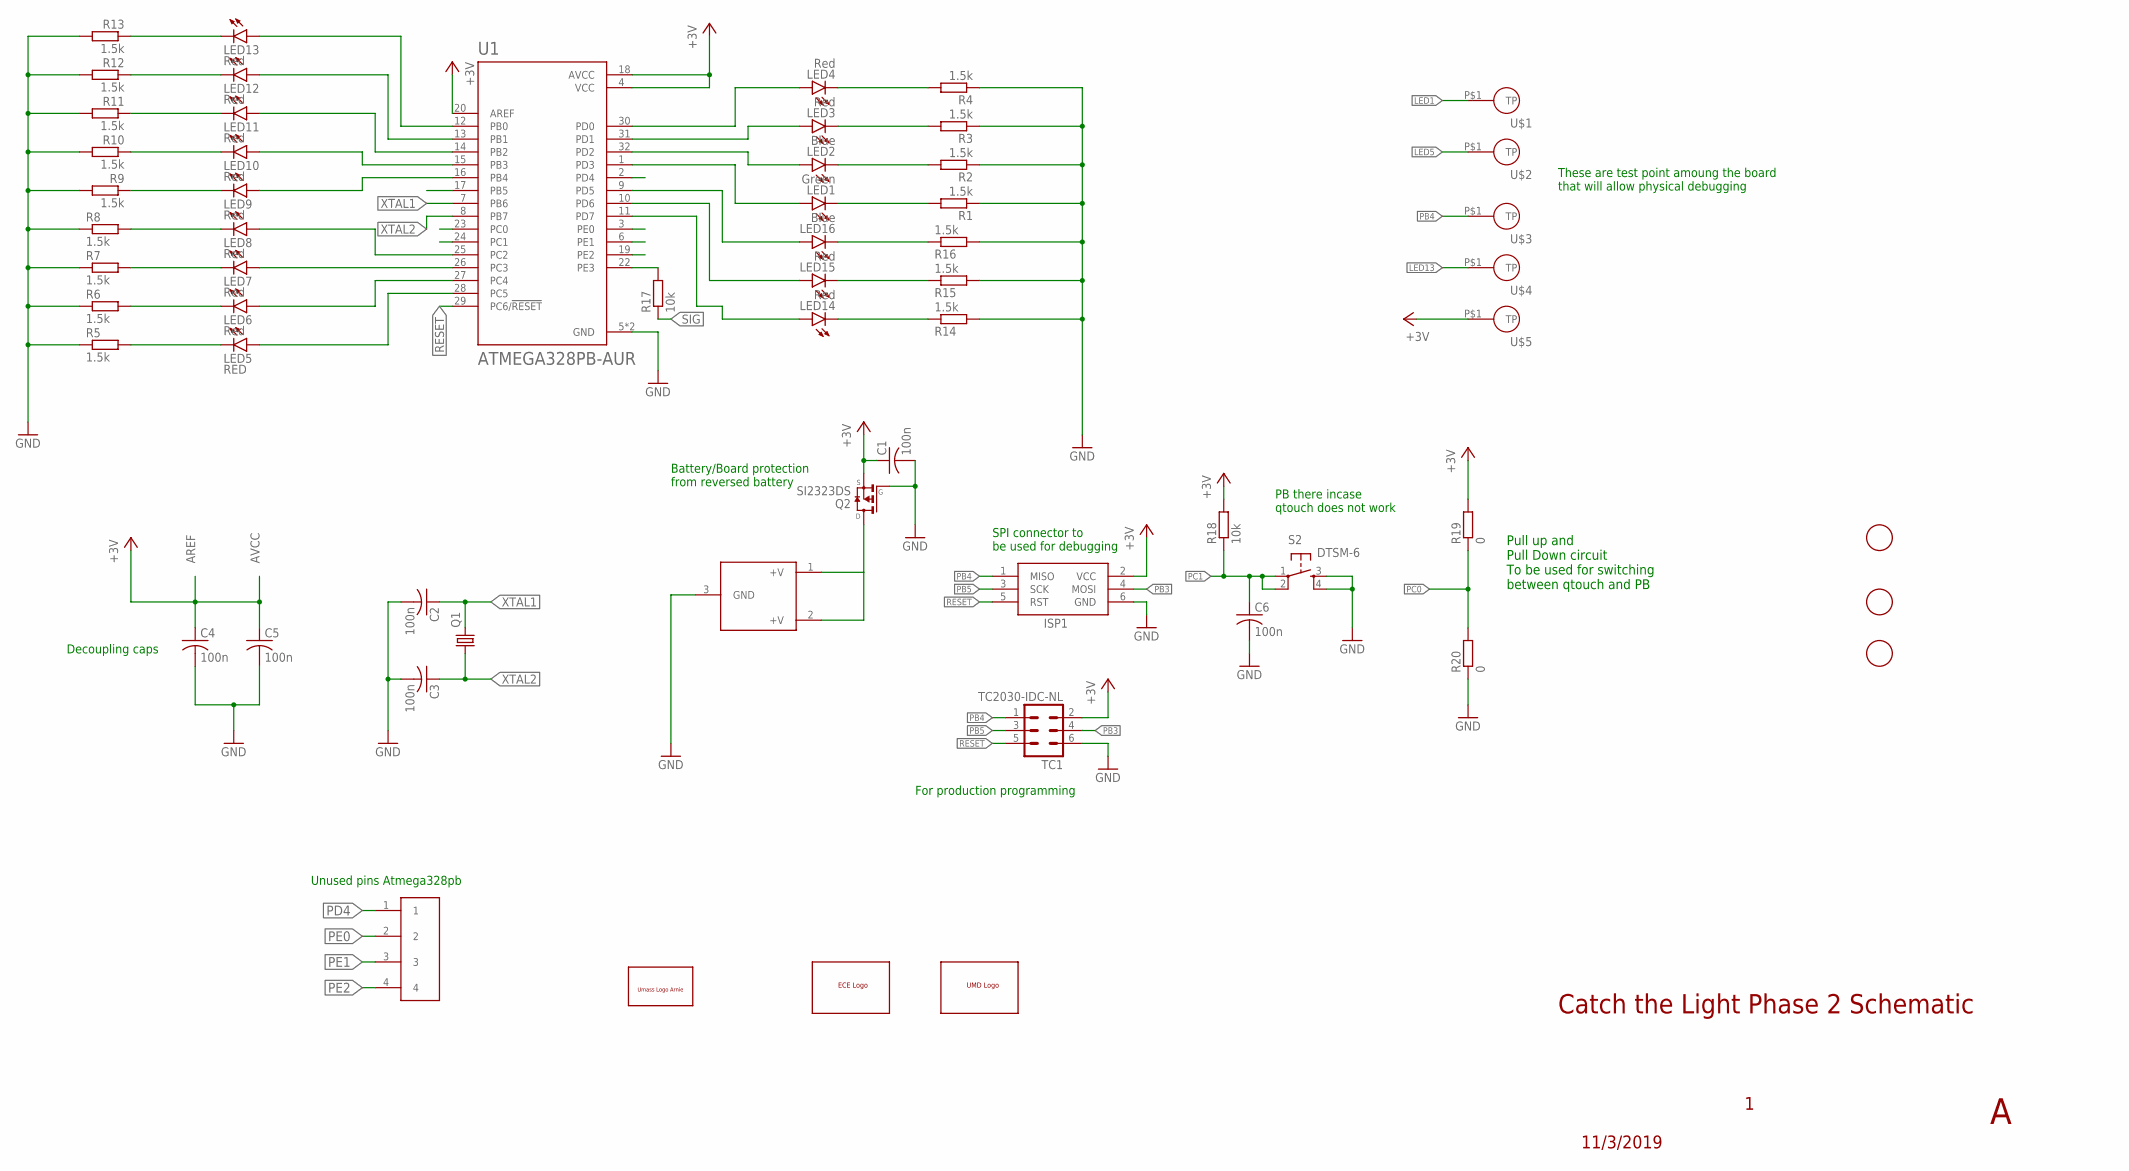
[picture p52: schematic Schematic.sch]

Parts:
C1, C2, C3, C4, C5, C6: 100n; C0805
CR2032: BC-2003SMD; BC-2003
ISP1: AVRISP-6; AVRISP
LED1: Green; CHIP-LED0805
LED2, LED16: Blue; CHIP-LED0805
LED3, LED4, LED6, LED7, LED8, LED9, LED10, LED11, LED12, LED13, LED14, LED15: Red; CHIP-LED0805
LED5: RED; CHIP-LED0805
Q1: CRYSTALHC49UP; HC49UP
Q2: SI2323DS; SOT23
R1, R2, R3, R4, R5, R6, R7, R8, R9, R10, R11, R12, R13, R14, R15, R16: 1.5k; R0805
R17, R18: 10k; R0805
R19, R20: 0; R0805
S2: DTSM-6
TC1: TC2030-IDC-NL
U1: ATMEGA328PB-AUR; QFP80P900X900X120-32N
U$1, U$2, U$3, U$4, U$5: TEST_POINT
U$6: PINHEADER; HEADERPIN
U$7, U$8, U$9: FIDUCIAL; FIDUCIAL_1MM
U$10: UMASSLGOARNIE; UMASSLOGOARNIE
U$11: ECE_LOGO; ECE
U$12: UMDLOGO

Connections:
+3V3: C1.1, C4.1, C5.1, ISP1.2 (VCC), Q2.2 (S), R18.2, R19.2, TC1.2, U1.4 (VCC), U1.18 (AVCC), U1.20 (AREF), U$5.P$1
GND: C1.2, C2.2, C3.2, C4.2, C5.2, C6.2, CR2032.3 (GND), ISP1.6 (GND), Q2.1 (G), R1.1, R2.1, R3.1, R4.1, R5.1, R6.1, R7.1, R8.1, R9.2, R10.2, R11.2, R12.2, R13.2, R14.2, R15.2, R16.2, R20.1, S2.3, S2.4, TC1.6, U1.5 (GND), U1.21 (GND)
LED1: LED1.A, U1.1 (PD3), U$1.P$1
LED5: LED5.A, U1.28 (PC5), U$2.P$1
LED12: LED12.A, U1.13 (PB1)
LED13: LED13.A, U1.12 (PB0), U$4.P$1
unnamed: LED5.C, R5.2
unnamed: CR2032.1 (+V), CR2032.2 (+V), Q2.3 (D)
unnamed: LED11.A, U1.14 (PB2)
unnamed: LED6.A, U1.27 (PC4)
unnamed: LED8.A, U1.25 (PC2)
unnamed: LED7.A, U1.26 (PC3)
unnamed: LED4.A, U1.30 (PD0)
unnamed: LED3.A, U1.31 (PD1)
unnamed: LED2.A, U1.32 (PD2)
unnamed: LED16.A, U1.9 (PD5)
unnamed: LED15.A, U1.10 (PD6)
unnamed: LED14.A, U1.11 (PD7)
unnamed: LED9.C, R9.1
unnamed: R17.2, U1.22 (PE3)
unnamed: LED8.C, R8.2
unnamed: LED7.C, R7.2
unnamed: LED6.C, R6.2
unnamed: LED4.C, R4.2
unnamed: LED3.C, R3.2
unnamed: LED2.C, R2.2
unnamed: LED1.C, R1.2
unnamed: LED10.C, R10.1
unnamed: LED11.C, R11.1
unnamed: LED12.C, R12.1
unnamed: LED13.C, R13.1
unnamed: LED14.C, R14.1
unnamed: LED15.C, R15.1
unnamed: LED16.C, R16.1
PB3: ISP1.4 (MOSI), LED10.A, TC1.4, U1.15 (PB3)
PB4: ISP1.1 (MISO), LED9.A, TC1.1, U1.16 (PB4), U$3.P$1
PB5: ISP1.3 (SCK), TC1.3, U1.17 (PB5)
PC0: R19.1, R20.2, U1.23 (PC0)
PC1: C6.1, R18.1, S2.1, S2.2, U1.24 (PC1)
PD4: U1.2 (PD4), U$6.1
PE0: U1.3 (PE0), U$6.2
PE1: U1.6 (PE1), U$6.3
PE2: U1.19 (PE2), U$6.4
RESET: ISP1.5 (RST), TC1.5, U1.29 (PC6/!RESET)
SIG: R17.1
XTAL1: C2.1, Q1.2, U1.7 (PB6)
XTAL2: C3.1, Q1.1, U1.8 (PB7)

Notes on the sheet:
AREF
AVCC
11/3/2019
Catch the Light Phase 2 Schematic
Pull up and Pull Down circuit To be used for switching between qtouch and PB
PB there incase qtouch does not work
SPI connector to be used for debugging
These are test point amoung the board that will allow physical debugging
For production programming
Battery/Board protection from reversed battery
Decoupling caps
Unused pins Atmega328pb

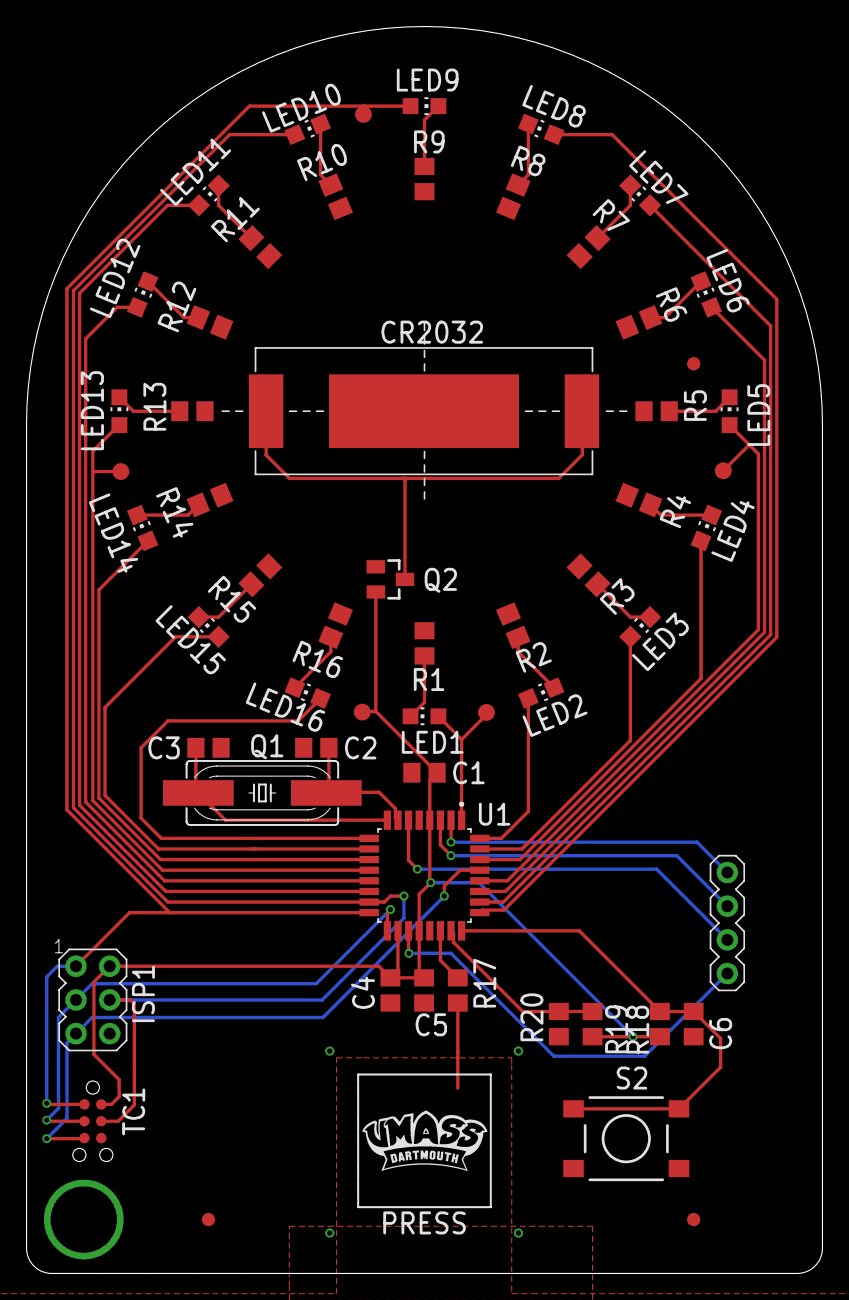
[picture p53: board Schematic.brd from above]

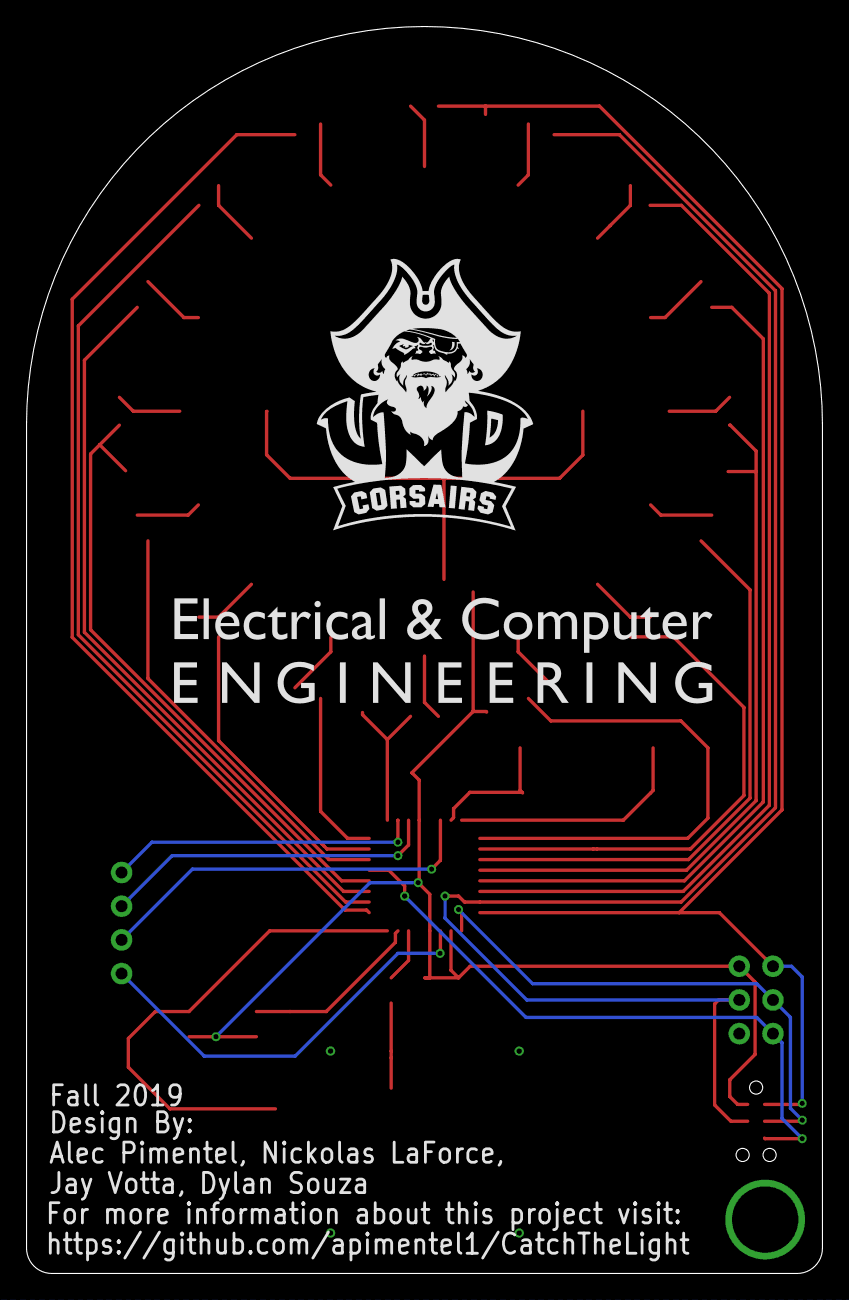
[picture p54: board Schematic.brd from below]

Board: 2 copper layers, 60.0 x 94.0 mm, 61 parts (2 on the bottom side), 46 nets.
