apimentel1/CatchTheLight/Initial design_reverse engineered/catch the light initial/catch the light initial.brd

## EAGLE design Initial design_reverse engineered/catch the light initial/catch the light initial.brd (2019-11-03)

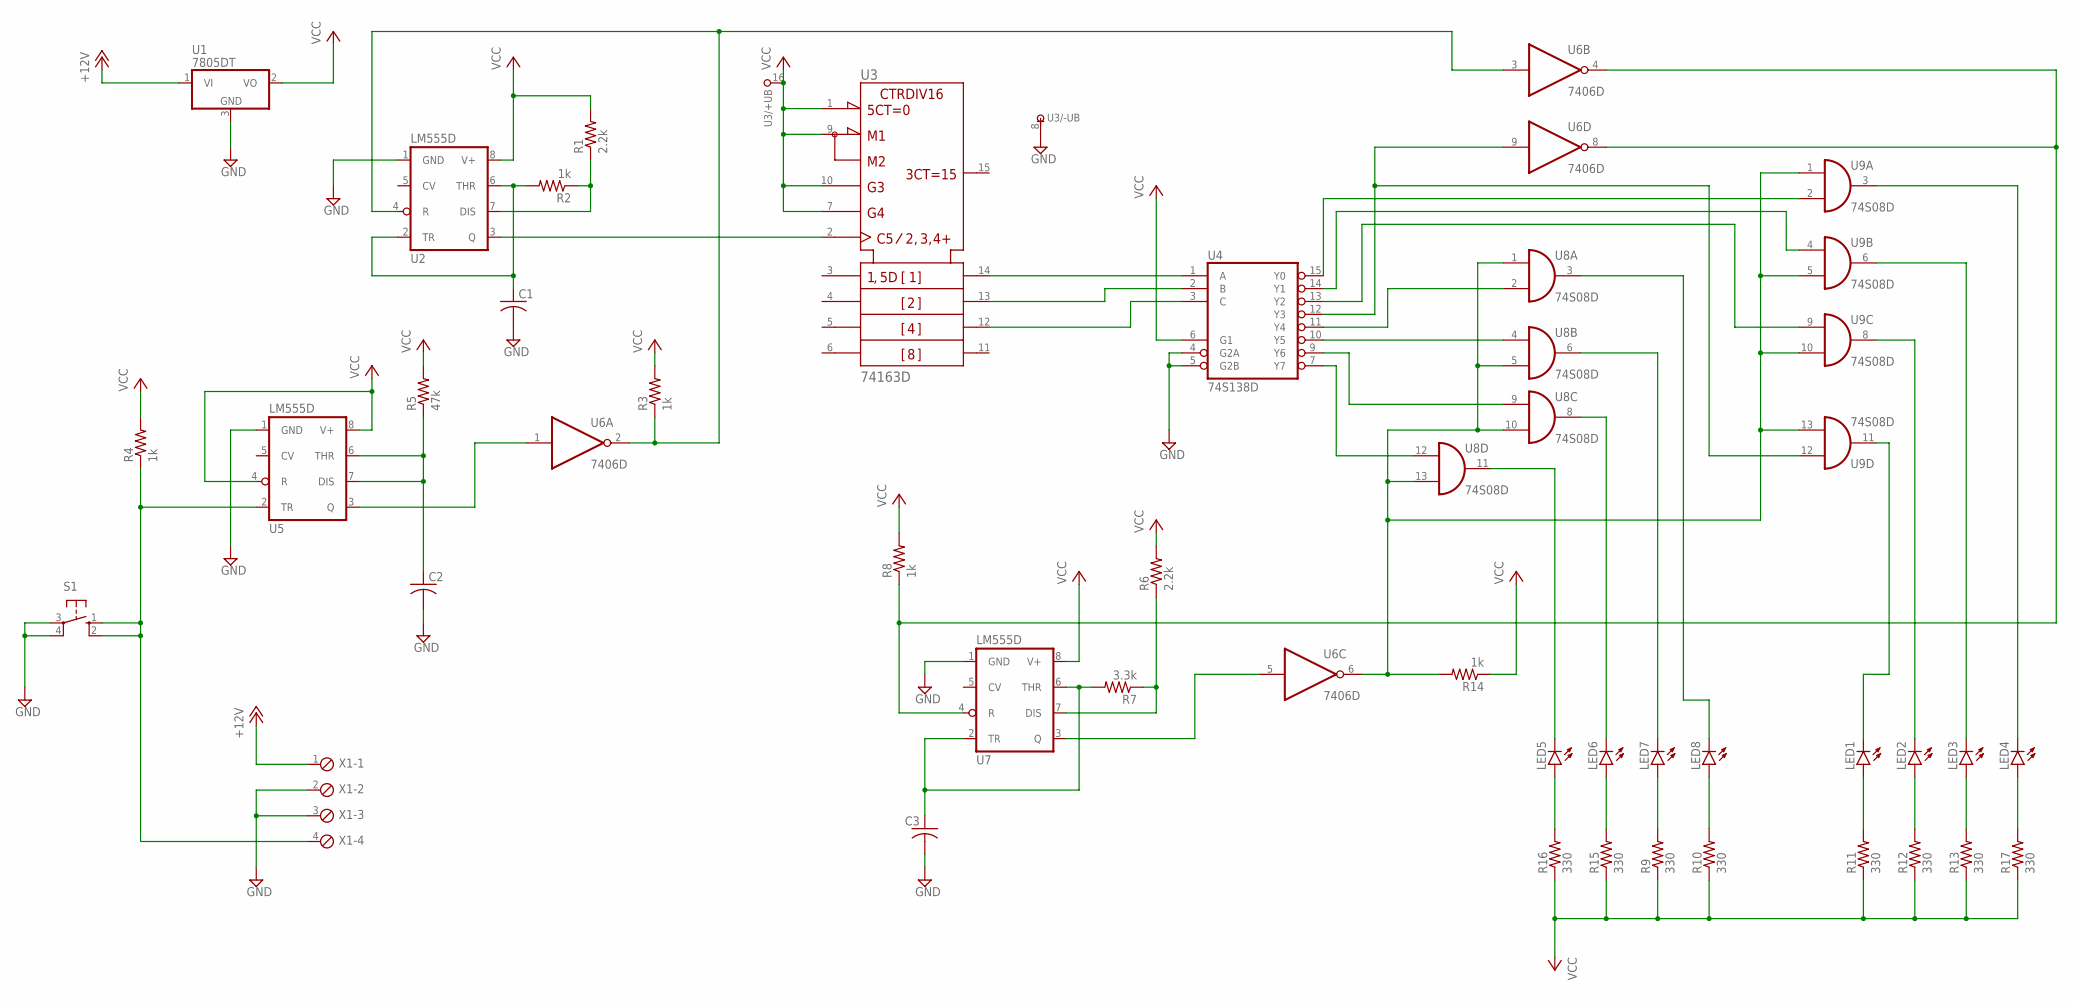
[picture p55: schematic catch the light initial.sch]

Parts:
C1, C2, C3: C-USC0805; C0805
LED1, LED2, LED3, LED4, LED5, LED6, LED7, LED8: LEDCHIP-LED0805; CHIP-LED0805
R1, R6: 2.2k; R0805
R2, R3, R4, R8, R14: 1k; R0805
R5: 47k; R0805
R7: 3.3k; R0805
R9, R10, R11, R12, R13, R15, R16, R17: 330; R0805
S1: 10-XX; B3F-10XX
U1: 7805DT; TO252
U2, U5, U7: LM555D; SO08
U3: 74163D; SO16
U4: 74S138D; SO16
U6: 7406D; SO14
U8, U9: 74S08D; SO14
X1: MPT4; 4POL254

Connections:
+12V: U1.1 (VI), X1.1
GND: C1.2, C2.2, C3.2, S1.3, S1.4 (P1), U1.3 (GND), U2.1 (GND), U3.8 (-UB), U4.4 (G2A), U4.5 (G2B), U4.8 (GND), U5.1 (GND), U6.7 (GND), U7.1 (GND), U8.7 (GND), U9.7 (GND), X1.2, X1.3
unnamed: C1.1, R2.2, U2.2 (TR), U2.6 (THR)
unnamed: U2.3 (Q), U3.2 (CLK)
unnamed: R3.1, U2.4 (R), U6.2 (O), U6.3 (I)
unnamed: C2.1, R5.1, U5.6 (THR), U5.7 (DIS)
unnamed: R1.1, R2.1, U2.7 (DIS)
unnamed: U3.14 (QA), U4.1 (A)
unnamed: U5.3 (Q), U6.1 (I)
unnamed: U3.13 (QB), U4.2 (B)
unnamed: U3.12 (QC), U4.3 (C)
unnamed: U4.7 (Y7), U8.12 (I0)
unnamed: U4.9 (Y6), U8.9 (I0)
unnamed: U4.10 (Y5), U8.4 (I0)
unnamed: U4.11 (Y4), U8.2 (I1)
unnamed: U4.12 (Y3), U6.9 (I), U9.12 (I0)
unnamed: U4.15 (Y0), U9.2 (I1)
unnamed: U4.13 (Y2), U9.9 (I0)
unnamed: U4.14 (Y1), U9.4 (I0)
unnamed: R8.1, U6.4 (O), U6.8 (O), U7.4 (R)
unnamed: C3.1, R7.2, U7.2 (TR), U7.6 (THR)
unnamed: R4.1, S1.1 (S), S1.2 (S1), U5.2 (TR), X1.4
unnamed: U6.5 (I), U7.3 (Q)
unnamed: LED5.C, U8.11 (O)
unnamed: R14.2, U6.6 (O), U8.1 (I0), U8.5 (I1), U8.10 (I1), U8.13 (I1), U9.1 (I0), U9.5 (I1), U9.10 (I1), U9.13 (I1)
unnamed: LED6.C, U8.8 (O)
unnamed: LED7.C, U8.6 (O)
unnamed: LED8.C, U8.3 (O)
unnamed: LED1.C, U9.11 (O)
unnamed: LED2.C, U9.8 (O)
unnamed: LED3.C, U9.6 (O)
unnamed: LED4.C, U9.3 (O)
unnamed: LED5.A, R16.2
unnamed: LED6.A, R15.2
unnamed: LED7.A, R9.2
unnamed: LED4.A, R17.2
unnamed: LED8.A, R10.2
unnamed: LED1.A, R11.2
unnamed: LED2.A, R12.2
unnamed: LED3.A, R13.2
unnamed: R6.1, R7.1, U7.7 (DIS)
VCC: R1.2, R3.2, R4.2, R5.2, R6.2, R8.2, R9.1, R10.1, R11.1, R12.1, R13.1, R14.1, R15.1, R16.1, R17.1, U1.2 (VO), U2.8 (V+), U3.1 (!CLR), U3.7 (ENP), U3.9 (!LOAD), U3.10 (ENT), U3.16 (+UB), U4.6 (G1), U4.16 (VCC), U5.4 (R), U5.8 (V+), U6.14 (VCC), U7.8 (V+), U8.14 (VCC), U9.14 (VCC)

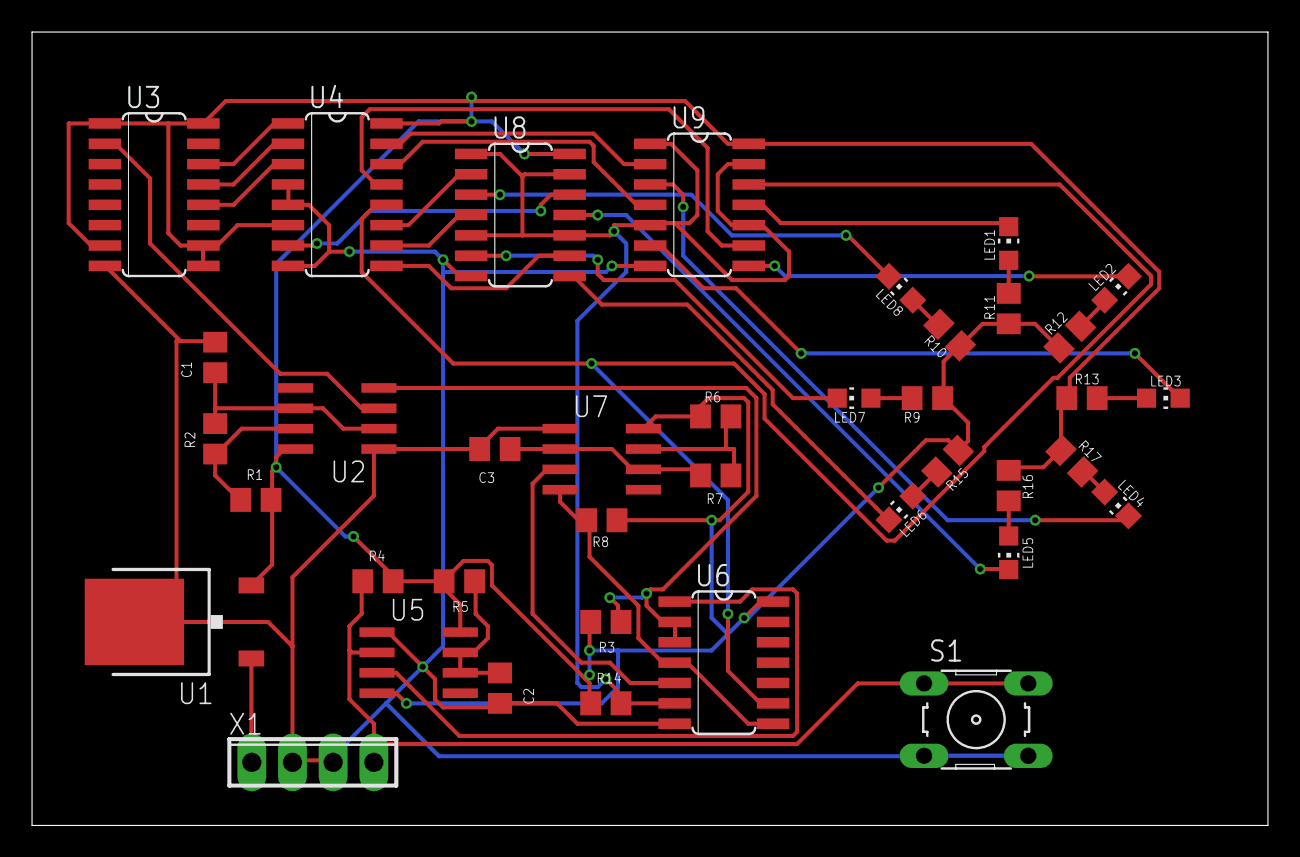
[picture p56: board catch the light initial.brd from above]

Board: 2 copper layers, 77.1 x 49.5 mm, 39 parts (0 on the bottom side), 42 nets.
