apimentel1/CatchTheLight/(commit log)

2019-10-25 Tag connector data sheet
2019-10-26 Started to update code for current PCB layout
2019-10-26 reversed the direction, leds can go in both directions
    [main.c]
2019-10-29 Added xplain-mini wiring diagram
2019-11-03 Create temp
    Reverse engineered layout with surface mount
2019-11-03 Phase 2 PCB design
    [PnP_Schematic_front.csv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]
2019-11-03 Added eagle file
    [Schematic.brd, Schematic.sch]
2019-11-04 Add files via upload
    Latest schematic pdf
2019-11-07 Added the new version of the eagle file
    [PnP_Schematic_front.csv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]
2019-11-11 Create Bill of Material
2019-11-11 Add files via upload
    B.O.M for 100 units
    [Catch the Light Project B.O.M (Units of 100).xlsx]
2019-11-11 Looks good
    [Catch the Light Project B.O.M (Units of 100).xlsx]
2019-11-11 Most current version of the board
    [PnP_Schematic_front.csv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]
2019-11-12 Added BoardLayout
2019-11-14 Added new gerbers
2019-11-25 Update Catch the Light Project B.O.M (Units of 100).xlsx
    [Catch the Light Project B.O.M (Units of 100).xlsx]
2019-11-30 Cleaned up repo
    [Battery tray bottom.dxf, Battery tray top.dxf, PnP_Schematic_front.csv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]
2019-12-01 Game works with a Push Button and LED are at full brightness
2019-12-01 Trying to figure out how qTouch works
    Not sure why USART needs to be used with qTouch, need to figure out as it effects the led on PD2
2019-12-04 Updates code that is running with push button on PCB
2019-12-05 add code to test current
2019-12-05 Sony CR2032 Battery Datasheet
2019-12-11 Leds cycle at right speed and cap touch works
2019-12-11 attemmpting to fix led staying on problem
    [main.c]
2019-12-12 Mulitsim Design File
    [catch the light.ms14]
2019-12-13 rearrange to avoid led staying on
    [main.c]
2019-12-13 added test code for button response time
