apimentel1/CatchTheLight/Documentation/Images/Phase1_Breadboard(1).jpg

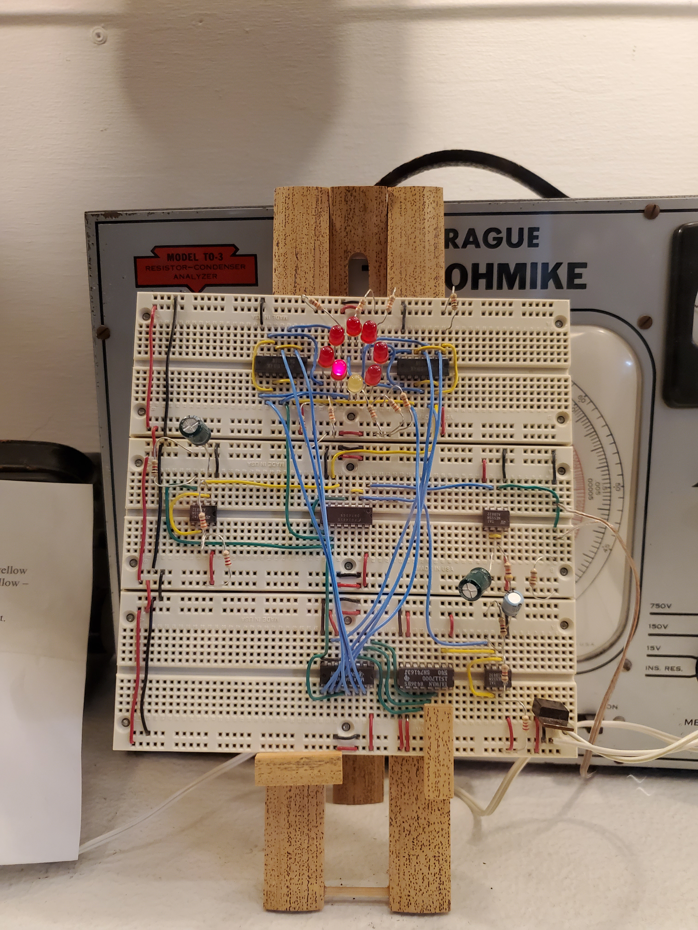
Documentation/Images/Phase1_Breadboard(1).jpg
